ultrazohm/uz_per_sic_inverter_828xcc/commissioning/bootstrap_noload/measurement_setup.jpg

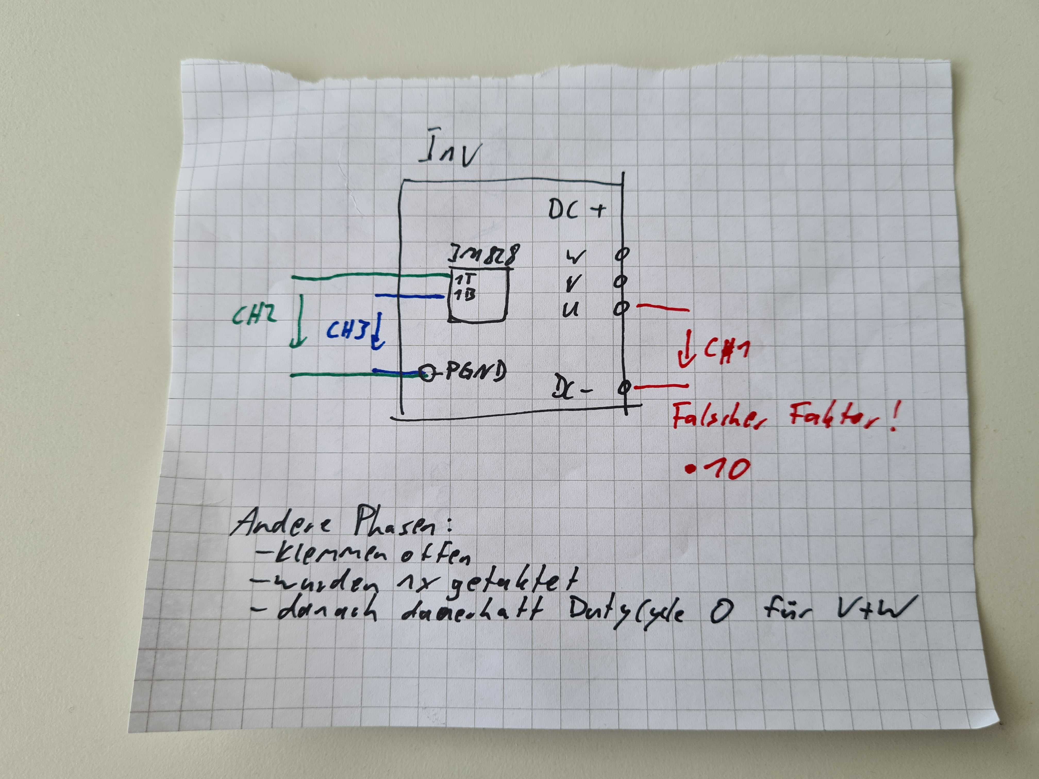
commissioning/bootstrap_noload/measurement_setup.jpg
