ultrazohm/uz_per_sic_inverter_828xcc/docs/PCB_interfaces.pptx

+24V

Ca. 100 mm

Kontur Kühlkörper, höhe 40 mm

Ca. 150 mm

Ca. 117 mm

DC+

GND

a

RJ45

IPM

b

Ca. 120 mm

RJ45

c

DC-

## Slide 2

Kühlkörper Bohrungen

Ca. 25 mm

Ca. 20 mm

IPM

Ca. 33.5 mm

Ca. 45 mm

Ca. 30 mm

Ca. 20 mm
