ultrazohm/uz_per_sic_inverter_828xcc/ghost.png

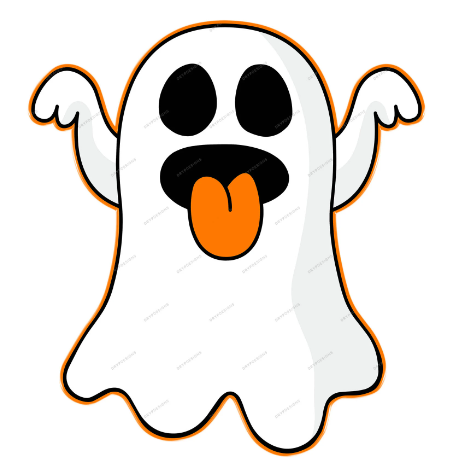
ghost.png
