ultrazohm/uz_per_sic_inverter_828xcc/docs/AssemblyForRev01JLCmissingParts.xlsx

BOT
Quantity | Comment | Designator | Value | Footprint | Supplier 1 | Supplier Part Number 1 | Supplier 2 | Supplier Part Number 2
1 | LQH43PN4R7M26L | L1 | 4.7 uH | IND | Mouser | 81-LQH43PN4R7M26L
2 | 22 µF | C6, C7 | 22 µF | C_1206 | Mouser | 810-C3216X5R1V226M
7 | 4.7 µF | C67A, C67B, C67C, C67D, C67E, C67F, C67G | 4.7 µF | C_0805 | Mouser | 810-C2012X7R475K125C
1 | LTC6992HS6-4#WTRMPBF | IC6 |  | SOT95P280X100-6N | Mouser | 584-6992HS64WTRMPBF
1 | IM828XCCXKMA1 | IC5 | 900V 20A | IM828XCCXKMA1 | Mouser | 726-IM828XCCXKMA1
TOP
1 | NXJ2S2415MC-R7 | IC3 | 2 W | DCDC | Mouser | 580-NXJ2S2415MC-R7
1 | NXJ2S0505MC-R7 | IC4 | 2 W | DCDC | Digi-Key | 811-3818-1-ND
5 | 22 µF | C17, C18, C37, C40, C42 | 22 µF | C_1206 | Mouser | 810-C3216X5R1V226M
2 | LQM31PN4R7M00L | L2, L3 | 375 mOhm | IND 1206_3216 | Mouser | 81-LQM31PN4R7M00L
1 | LM4040 5.0V | D1 | LM4040 5.0V | SOT-23-3 | Mouser | 700-LM4040CIM3-5.0T
3 | 4.7 µF | C13, C16, C23 | 4.7 µF | C_0805 | Mouser | 810-C2012X7R475K125C
4 | TC7SZ86FU,LJ(CT | IC13A, IC13B, IC13C, IC13D | 5.5 V | SOT353-1_N | Mouser | 757-TC7SZ86FULJCT | Digi-Key | TC7SZ86FULJ(CTCT-ND
4 | LM2903M8-13 | IC12A, IC12B, IC12C, IC12D |  | MSOP-8 (RM-8) | Mouser | 621-LM2903M8-13
1 | VO617A-2X017T | OP1 |  | SMD4 | Mouser | 78-VO617A-2X017T
1 | SN74HCS32PWR | IC1 | 6 V | TSSOP-14 | Mouser | 595-SN74HCS32PWR
10 | 40 µF | C24, C25, C26, C27, C28, C29, C30, C31, C32, C33 | 40 µF | B32778Z | Mouser | 871-B32778Z0406K000
2 | 100 nF | C34, C35 | 100 nF | WIMA | Mouser | 505-M10.1/1600/10P
1 | RJHSE538002 | J10 |  | RJHSE-5380-02 | Farnell | 1860605
7 | HFBR-2521Z | J1A, J1B, J1C, J1D, J1E, J1F, J1G |  | HFBRx5XX | Mouser | 630-HFBR-2521Z | Digi-Key
2 | HFBR-1521Z | J2A, J2B |  | HFBRx5XX | Mouser | 630-HFBR-1521Z | Digi-Key | 516-2043-ND
3 | FCR7350B, PCB mount 4mm jack, BLACK | J3, J6, J9 | PCB mount 4mm jack, Black FCR7350B, 1000V, 24A | FCR7350 | Digi-Key | 3185-FCR7350B-ND | farnell | 1854507
2 | FCR7350R, PCB mount 4mm jack, RED | J4, J5 | PCB mount 4mm jack, Red FCR7350R, 1000V, 24A | FCR7350 | Digi-Key | 3185-FCR7350R-ND | farnell | 1854508
2 | FCR7350L, PCB mount 4mm jack, BLUE | J7, J8 | PCB mount 4mm jack, Blue FCR7350L, 1000V, 24A | FCR7350 | Digi-Key | 3185-FCR7350L-ND | farnell | 1854511
4 | CAS5015SRA-LI | IC8A, IC8B, IC8C, IC8D |  |  | Sensitec | CAS5015SRA-LI
SUM | 68
