ultrazohm/uz_per_sic_inverter_828xcc/Project Outputs for UZ_PER_SiC_inverter_828xcc/BOM/BOM_UZ_PER_SiC_inverter_828xcc_Rev01 - Kopie.xlsx

Quantity | Comment | Designator | MF | MPN | Value | Description | Footprint | Package | Voltage | Dielectric | Supplier 1 | Supplier Part Number 1 | Supplier 2 | Supplier Part Number 2 | Supplier 3 | Supplier Part Number 3 | Anzahl Boards |  |  | Vorhanden | Bestellt bei
44 | 0.1 µF | C1, C2, C5, C8, C9, C14, C15, C21, C22, C38, C39, C41, C43, C44, C57A, C57B, C57C, C57D, C61A, C61B, C61C, C61D, C64A, C64B, C64C, C64D, C66A, C66B, C66C, C66D, C66E, C66F, C66G, C68A, C68B, C71A, C71B, C71C, C71D, C72A, C72B, C72C, C72D, C73 |  |  | 0.1 µF | Capacitor 0603, 50 VDC, 0.1 µF, X7R | C_0603 |  |  |  | Mouser | 80-C0603X104K5R7411 | LCSC | C14663 |  |  | 7 | 308
9 | 10 µF | C3, C4, C10, C11, C12, C19, C20, C69, C70 |  |  | 10 µF | Capacitor 1206, 50 VDC, 10 µF, X7R | C_1206 |  |  |  | Mouser | 810-CGA5L1X7R1H106K1 |  |  |  |  | 7 | 63
7 | 22 µF | C6, C7, C17, C18, C37, C40, C42 |  |  | 22 µF | Capacitor 1206, 35 VDC, 22µF, X5R | C_1206 |  |  |  | Mouser | 810-C3216X5R1V226M |  |  |  |  | 7 | 49 | x | 60 | Mouser
10 | 4.7 µF | C13, C16, C23, C67A, C67B, C67C, C67D, C67E, C67F, C67G |  |  | 4.7 µF | Capacitor 0805, 50 VDC, 4.7 µF, X7R | C_0805 |  |  |  | Mouser | 810-C2012X7R475K125C |  |  |  |  | 7 | 70 | x | 100 | Mouser
10 | 40 µF | C24, C25, C26, C27, C28, C29, C30, C31, C32, C33 |  |  | 40 µF | Film Capacitors, 40 µF, 1000 VDC for DC Link | B32778Z |  |  |  | Mouser | 871-B32778Z0406K000 |  |  |  |  | 7 | 70 | x | 50 | Mouser 20
2 | 100 nF | C34, C35 |  |  | 100 nF | Folienkondensatoren 1600V .10uF 10% PCM 27.5 | WIMA |  |  |  | Mouser | 505-M10.1/1600/10P |  |  |  |  | 7 | 14 | x | 20 | Mouser
15 | 1 nF | C36, C45, C46, C47, C48, C49, C50, C56A, C56B, C56C, C56D, C65A, C65B, C65C, C65D |  |  | 1 nF | Capacitor 0603, 50 VDC, 1 nF, C0G, Capacitor 0603, 50 VDC, 1 nF, NP0 | C_0603 |  |  |  | Mouser, LCSC | 581-06035A102J, C106246 |  |  |  |  | 7 | 105
8 | 330 pF | C51A, C51B, C51C, C51D, C55A, C55B, C55C, C55D |  |  | 330 pF | Capacitor 0603, 50 VDC, 330 pF, X7R | C_0603 |  |  |  | Mouser | 80-C0603X331J5R3112 |  |  |  |  | 7 | 56
16 | 22 pF | C52A, C52B, C52C, C52D, C54A, C54B, C54C, C54D, C58A, C58B, C58C, C58D, C63A, C63B, C63C, C63D |  |  | 22 pF | Capacitor 0603, 50 VDC, 22 pF, X7R | C_0603 |  |  |  | Mouser | 80-C0603C220J5R |  |  |  |  | 7 | 112
12 | 1 µF | C53A, C53B, C53C, C53D, C59A, C59B, C59C, C59D, C62A, C62B, C62C, C62D |  |  | 1 µF | 50V 1uF X7R ±10% 0603 Multilayer Ceramic Capacitors MLCC - SMD/SMT ROHS | C_0603 |  |  |  | LCSC | C105174 | Mouser | 963-UMK107AB7105MA-T |  |  | 7 | 84
4 | 2.2 nF | C60A, C60B, C60C, C60D |  |  | 2.2 nF | Capacitor 0603, 50 VDC, 2.2 nF, X7R | C_0603 |  |  |  | Mouser | 581-06035C222J |  |  |  |  | 7 | 28
1 | LM4040 5.0V | D1 |  |  | LM4040 5.0V | Voltage Reference, 5.0V, ±0.5%, ±15mA | SOT-23-3 |  |  |  | Mouser | 700-LM4040CIM3-5.0T |  |  |  |  | 7 | 7 | x | 10 | Mouser
7 | 150060RS86000 | D2A, D2B, D2C, D2D, D2E, D2F, D2G |  |  |  | WL-SMCW SMD Mono-color Chip LED Waterclear Red | WL-SMCW_0603 |  |  |  | Mouser | 710-150060RS86000 | Farnell | 3408608 | Digi-Key | 732-150060RS86000CT-ND | 7 | 49
6 | 150060GS84000 | D3A, D3B, D4, D5, D6, D7 |  |  |  | WL-SMCW SMD Mono-color Chip LED Waterclear Green | WL-SMCW_0603 |  |  |  | Mouser | 710-150060GS84000 | Farnell | 3408612 | Digi-Key | 732-150060GS84000CT-ND | 7 | 42
1 | 0154.500DR | F1 |  |  | 500 mA | Fuse OMNI BLOK 154 | Littlefuse_154 |  |  |  | Mouser | 576-0154.500DR |  |  |  |  | 7 | 7
1 | SN74HCS32PWR | IC1 |  |  | 6 V | Logische Gatter Quadruple 2-input OR gates with Schmitt-trigger inputs 14-TSSOP -40 to 125 | TSSOP-14 |  |  |  | Mouser | 595-SN74HCS32PWR |  |  |  |  | 7 | 7 | x | 10 | Mouser
1 | AP63205WU-7 | IC2 |  |  |  | Switching Voltage Regulators DCDC Conv HV Buck TSOT26 T&R 3K | TSOT26-6 |  |  |  | Mouser | 621-AP63205WU-7 |  |  |  |  | 7 | 7 |  | 10
1 | NXJ2S2415MC-R7 | IC3 |  |  | 2 W | Isolated DC/DC Converters - SMD 21.6V TO 26.4V IN 15V OUT | DCDC |  |  |  | Mouser | 580-NXJ2S2415MC-R7 |  |  |  |  | 7 | 7 | x | 5 | Farnell 3
1 | NXJ2S0505MC-R7 | IC4 |  |  | 2 W | Isolated DC/DC Converters - SMD 4.5V TO 5.5V IN 5V OUT | DCDC |  |  |  | Digi-Key | 811-3818-1-ND |  |  |  |  | 7 | 7 | x | 6 | Digikey 3
1 | IM828XCCXKMA1 | IC5 |  |  | 900V 20A | Motor/Motion/Ignition Controllers & Drivers SiC MOSFET | IM828XCCXKMA1 |  |  |  | Mouser | 726-IM828XCCXKMA1 |  |  |  |  | 7 | 7 | x | 5 | Mouser 3
1 | LTC6992HS6-4#WTRMPBF | IC6 |  |  |  | Switching Controllers PWM with 5% to 100% Pulse Width Control | SOT95P280X100-6N |  |  |  | Mouser | 584-6992HS64WTRMPBF |  |  |  |  | 7 | 7 |  | 10
8 | ADA4940-1ARZ-R7 | IC7A, IC7B, IC7C, IC7D, IC9A, IC9B, IC9C, IC9D |  |  | differential ADC driver | Differential ADC Driver | SOIC-8-N |  |  |  | Mouser | 584-ADA4940-1ARZ-R7 |  |  |  |  | 7 | 56 |  | 50
4 | CAS5015SRA-LI | IC8A, IC8B, IC8C, IC8D |  |  | 15A | 15A, 1.1%, 400kHz | CAS50xxSRA |  |  |  | RS | 216-9746 |  |  |  |  | 7 | 28 | x | 20 | n. bestellt
9 | SN74LVC1G14DBV | IC10A, IC10B, IC10C, IC10D, IC10E, IC10F, IC10G, IC11A, IC11B |  |  | 5.5 V | Inverting Schmitt trigger | SOT23-5_L |  |  |  | Mouser | 595-SN74LVC1G14DBVT |  |  |  |  | 7 | 63 |  | 70
4 | LM2903M8-13 | IC12A, IC12B, IC12C, IC12D |  |  |  | Analoge Komparatoren Comparator | MSOP-8 (RM-8) |  |  |  | Mouser | 621-LM2903M8-13 |  |  |  |  | 7 | 28 | x | 35 | Digikey
4 | TC7SZ86FU,LJ(CT | IC13A, IC13B, IC13C, IC13D |  |  | 5.5 V | IC GATE XOR 1CH 2-INP USV | SOT353-1_N |  |  |  | Mouser | 757-TC7SZ86FULJCT | Digi-Key | TC7SZ86FULJ(CTCT-ND |  |  | 7 | 28 | x | 10 | Digikey 30
7 | HFBR-2521Z | J1A, J1B, J1C, J1D, J1E, J1F, J1G | Boadcom/Avago | HFBR-2521Z |  | Fibre Optic Receivers, LINK HORIZ 5MBd RC VR RoHS | HFBRx5XX |  |  |  | Mouser | 630-HFBR-2521Z | Digi-Key |  |  |  | 7 | 49 | x | 35
2 | HFBR-1521Z | J2A, J2B | Broadcom/Avago | HFBR-1521Z |  | Fibre Optic Transmitters, Link Horiz 5MBd Tx RoHS | HFBRx5XX |  |  |  | Mouser | 630-HFBR-1521Z | Digi-Key | 516-2043-ND |  |  | 7 | 14 | x | 10
3 | FCR7350B, PCB mount 4mm jack, BLACK | J3, J6, J9 |  |  | PCB mount 4mm jack, Black FCR7350B, 1000V, 24A | FCR7350B, 1000V, 24A, BLACK | FCR7350 |  |  |  | Digi-Key | 3185-FCR7350B-ND | farnell | 1854507 |  |  | 7 | 21 | x | 15 | Farnell 6
2 | FCR7350R, PCB mount 4mm jack, RED | J4, J5 |  |  | PCB mount 4mm jack, Red FCR7350R, 1000V, 24A | FCR7350B, 1000V, 24A, RED | FCR7350 |  |  |  | Digi-Key | 3185-FCR7350R-ND | farnell | 1854508 |  |  | 7 | 14 | x | 10 | Farnell 4
2 | FCR7350L, PCB mount 4mm jack, BLUE | J7, J8 |  |  | PCB mount 4mm jack, Blue FCR7350L, 1000V, 24A | FCR7350B, 1000V, 24A, BLUE | FCR7350 |  |  |  | Digi-Key | 3185-FCR7350L-ND | farnell | 1854511 |  |  | 7 | 14 | x | 1 | Farnell 13
1 | RJHSE538002 | J10 |  |  |  | CAT5, RJ45 Connector, 1x2 | RJHSE-5380-02 |  |  |  | Farnell | 1860605 |  |  |  |  | 7 | 7 | x | 10 | Farnell
1 | LQH43PN4R7M26L | L1 | EPCOS / TDK | B82464G4154M | 4.7 uH | Leistungsinduktivitäten – SMD 4.7 UH 20% | IND |  |  |  | Mouser | 81-LQH43PN4R7M26L |  |  |  |  | 7 | 7 | x | 20 | Mouser
2 | LQM31PN4R7M00L | L2, L3 | EPCOS / TDK | B82464G4154M | 375 mOhm | Power Inductors - SMD 4.7 UH 20% | IND 1206_3216 |  |  |  | Mouser | 81-LQM31PN4R7M00L |  |  |  |  | 7 | 14 |  | 25
1 | VO617A-2X017T | OP1 |  |  |  | Transistor-Ausgangsoptokoppler H. Relblty 5300 Vrms 63-125% CTR, VDE | SMD4 |  |  |  | Mouser | 78-VO617A-2X017T |  |  |  |  | 7 | 7 | x | 10 | Farnell
1 | T2N7002AK,LM | Q1 |  |  | 60 V | Small-signal MOSFET, n-Channel, 200 mA, 60 V | SOT-23-3 |  |  |  | Mouser | 757-T2N7002AKLM | Digi-Key | T2N7002AKLMCT-ND |  |  | 7 | 7 |  | 10
2 | 270R | R1, R2 |  |  | 270R | SMD resistor E24 series | RES 0603_1608 |  |  |  | Mouser | 660-RK73B1JTTDD271J |  |  |  |  | 7 | 14
6 | 10k | R3, R51A, R51B, R52A, R52B, R61 |  |  | 10k | SMD resistor 1%, SMD resistor E24 series | RES 0603_1608 |  |  |  | Farnell, Mouser | 2447230, 660-RK73B1JTTD103J |  |  |  |  | 7 | 42
3 | 18k | R4, R56, R58 |  |  | 18k | SMD resistor E24 series | RES 0603_1608 |  |  |  | Mouser | 660-RK73B1JTTD183J |  |  |  |  | 7 | 21
39 | 100R | R5, R11, R12, R13, R14, R15, R16, R25A, R25B, R25C, R25D, R27A, R27B, R27C, R27D, R28A, R28B, R28C, R28D, R30A, R30B, R30C, R30D, R40A, R40B, R40C, R40D, R42A, R42B, R42C, R42D, R43A, R43B, R43C, R43D, R45A, R45B, R45C, R45D |  |  | 100R | SMD resistor E24 series | RES 0603_1608 |  |  |  | Mouser | 660-RK73B1JTTD101J | LCSC | C22775 |  |  | 7 | 273
1 | 12k | R6 |  |  | 12k | SMD resistor E24 series 12 kOhms 100mW 0603 1% | RES 0603_1608 |  |  |  | Mouser | 603-AC0603FR-1012KL |  |  |  |  | 7 | 7
1 | 470k | R7 |  |  | 470k | SMD resistor E24 series 470 kOhms 100-200 mW 0603 1% | RES 0603_1608 |  |  |  | Mouser | 603-RC0603FR-10470KL |  |  |  |  | 7 | 7
1 | 287k | R8 |  |  | 287k | SMD resistor 1% | RES 0805_2012 |  |  |  | Mouser | 667-ERJ-6ENF2873V |  |  |  |  | 7 | 7
1 | 976k | R9 |  |  | 976k | SMD resistor 1%, 50V, 100ppm | RES 0603_1608 |  |  |  | Mouser | 652-CR0603FX-9763ELF |  |  |  |  | 7 | 7
1 | 182k | R10 |  |  | 182k | SMD resistor 1%, 50V, 100ppm | RES 0603_1608 |  |  |  | Mouser | 652-CR0603FX-1823ELF |  |  |  |  | 7 | 7
48 | 330K | R17A, R17B, R17C, R17D, R18A, R18B, R18C, R18D, R19A, R19B, R19C, R19D, R20A, R20B, R20C, R20D, R21A, R21B, R21C, R21D, R22A, R22B, R22C, R22D, R33A, R33B, R33C, R33D, R34A, R34B, R34C, R34D, R35A, R35B, R35C, R35D, R36A, R36B, R36C, R36D, R37A, R37B, R37C, R37D, R38A, R38B, R38C, R38D |  |  | 330K | SMD resistor E24 series 330K OHM 1% 50PPM 1/4W | RES 1206_3216 |  |  |  | Mouser | 603-RT1206FRE07330KL |  |  |  |  | 7 | 336
16 | 220k | R23A, R23B, R23C, R23D, R24A, R24B, R24C, R24D, R31A, R31B, R31C, R31D, R32A, R32B, R32C, R32D |  |  | 220k | SMD resistor 1% | RES 0603_1608 |  |  |  | Mouser | 603-AC0603FR-07220KL |  |  |  |  | 7 | 112
8 | 22K | R26A, R26B, R26C, R26D, R29A, R29B, R29C, R29D |  |  | 22K | SMD resistor E24 series 22K 0.5% 1/10W 75 Volts 50ppm | RES 0603_1608 |  |  |  | Mouser | 603-RT0603DRE0722KL |  |  |  |  | 7 | 56
8 | 2k | R39A, R39B, R39C, R39D, R46A, R46B, R46C, R46D |  |  | 2k | SMD resistor 0.1% | RES 0603_1608 |  |  |  | Mouser | 667-ERA-3VEB2001V |  |  |  |  | 7 | 56
8 | 1k | R41A, R41B, R41C, R41D, R44A, R44B, R44C, R44D |  |  | 1k | SMD resistor 0.1% | RES 0603_1608 |  |  |  | Mouser | 66-PCFW0603LF031001B |  |  |  |  | 7 | 56
7 | 43k | R47A, R47B, R47C, R47D, R47E, R47F, R47G |  |  | 43k | SMD resistor E24 series | RES 0603_1608 |  |  |  | Mouser | 660-RK73B1JTTD433J |  |  |  |  | 7 | 49
12 | 3k9 | R48A, R48B, R48C, R48D, R48E, R48F, R48G, R49A, R49B, R57, R59, R60 |  |  | 3k9 | SMD resistor E24 series | RES 0603_1608 |  |  |  | Mouser | 660-RK73B1JTTDD392J |  |  |  |  | 7 | 84
2 | 150R | R50A, R50B |  |  | 150R | SMD resistor E24 series | RES 0603_1608 |  |  |  | Mouser | 660-RK73B1JTTD151J |  |  |  |  | 7 | 14
8 | 5.6k | R53A, R53B, R53C, R53D, R55A, R55B, R55C, R55D |  |  | 5.6k | SMD resistor E24 series 5.6 kOhms 100mW 0603 1% | RES 0603_1608 |  |  |  | Mouser | 603-AC0603FR-075K6L |  |  |  |  | 7 | 56
4 | 33k | R54A, R54B, R54C, R54D |  |  | 33k | SMD resistor E24 series | RES 0603_1608 |  |  |  | Mouser | 603-AC0603FR-1333KL |  |  |  |  | 7 | 28
