ultrazohm/uz_per_sic_inverter_828xcc/docs/IM828_kritIC_Liste.xlsx

Herstellernr |  | Menge pro pcb | Für 5PCB
NXJ2S2415MC | NXJ2S2415MC-R7 | 1 | 5
AP63205 | AP63205WU-7 | 1 | 5
IM828XCC | IM828XCCXKMA1 | 1 | 5
SN74LVC1G14 | SN74LVC1G14DBVT | 11 | 55
ADA4940 | ADA4940-1ARZ | 8 | 40
CAS5000 | CAS5025SRA-LI | 4 | 20
LTC6992 | LTC6992HS6-4#WTRMPBF | 1 | 5
NXJ2S0505MC |  | 1 | 5
 |  |  | 0
LQM31PN4R7M00L |  | 3 | 15
B32778Z |  | 10 | 50
2220Y6300105KXTWS2 |  | 6 | 30
LTV-356T |  | 1 | 5
LM358DR |  | 1 | 5
TC7SZ86FU,LJ(CT |  | 1 | 5
T2N7002AK,LM |  | 1 | 5
4mm Buchse bk |  | 3 | 15 | 17 bestellt wegen phase fault pcb
4mm Buchse rd |  | 2 | 10
4mm Buchse bl |  | 2 | 10
