ultrazohm/uz_per_sic_inverter_828xcc/(list of files, cad)

Other CAD files:
cad/IC8C.SLDASM
cad/R71D.SLDASM
cad/R91A-subassembly-1.SLDASM
cad/IC6A.SLDASM
cad/R19-subassembly-1.SLDASM
cad/J2B.SLDASM
cad/R2.SLDASM
cad/R33B-subassembly-1.SLDASM
cad/R82A-subassembly-1.SLDASM
cad/R91D-subassembly-1.SLDASM
cad/R80B-subassembly-1.SLDASM
cad/R72A.SLDASM
cad/R80B.SLDASM
cad/C13.SLDASM
cad/C35.SLDASM
cad/R86B.SLDASM
cad/C71F.SLDASM
cad/R40D-subassembly-1.SLDASM
cad/C71C.SLDASM
cad/R80D.SLDASM
cad/R74B.SLDASM
cad/R93B.SLDASM
cad/C66D.SLDASM
cad/R92A-subassembly-1.SLDASM
cad/C54C.SLDASM
cad/R89D.SLDASM
cad/R31-subassembly-1.SLDASM
cad/R84D-subassembly-1.SLDASM
cad/C64C.SLDASM
cad/C37.SLDASM
cad/R37B.SLDASM
cad/R71C.SLDASM
cad/C28-subassembly-1.SLDASM
cad/C66A.SLDASM
cad/R34D-subassembly-1.SLDASM
cad/R48A-subassembly-1.SLDASM
cad/R54B.SLDASM
cad/R41B.SLDASM
cad/R24.SLDASM
cad/R43D-subassembly-1.SLDASM
cad/C22.SLDASM
cad/R61B.SLDASM
cad/R70C.SLDASM
cad/C27.SLDASM
cad/L2.SLDASM
cad/C26-subassembly-1.SLDASM
cad/R87D.SLDASM
cad/R27.SLDASM
cad/R48D.SLDASM
cad/R33D.SLDASM
cad/R87C-subassembly-1.SLDASM
cad/R42B.SLDASM
cad/R82C-subassembly-1.SLDASM
cad/R3-subassembly-1.SLDASM
cad/R32C.SLDASM
cad/R69D-subassembly-1.SLDASM
cad/C72-subassembly-1.SLDASM
cad/R62C-subassembly-1.SLDASM
cad/C21.SLDASM
cad/Pins-2.SLDASM
cad/R57B.SLDASM
cad/R52D-subassembly-1.SLDASM
cad/R50D.SLDASM
cad/R59B.SLDASM
cad/C15.SLDASM
cad/R52A-subassembly-1.SLDASM
cad/R59D-subassembly-1.SLDASM
cad/R42A-subassembly-1.SLDASM
cad/R66B.SLDASM
cad/R55C.SLDASM
cad/C68B.SLDASM
cad/R42D.SLDASM
cad/R80A.SLDASM
cad/D1D.SLDASM
cad/R38C-subassembly-1.SLDASM
cad/C38-subassembly-1.SLDASM
cad/C56A.SLDASM
cad/C70B.SLDASM
cad/R54A-subassembly-1.SLDASM
cad/C68D.SLDASM
cad/R22-subassembly-1.SLDASM
cad/R56D.SLDASM
cad/R46B.SLDASM
cad/R67D-subassembly-1.SLDASM
cad/C4.SLDASM
cad/R86A-subassembly-1.SLDASM
cad/C66B.SLDASM
cad/R83A-subassembly-1.SLDASM
cad/R93C-subassembly-1.SLDASM
cad/R23-subassembly-1.SLDASM
cad/IC7D.SLDASM
cad/R86A.SLDASM
cad/R39A.SLDASM
cad/C70E.SLDASM
cad/J5.SLDASM
cad/R77C-subassembly-1.SLDASM
cad/R32D-subassembly-1.SLDASM
cad/R17.SLDASM
cad/R87D-subassembly-1.SLDASM
cad/R82B-subassembly-1.SLDASM
cad/R79D-subassembly-1.SLDASM
cad/R80C-subassembly-1.SLDASM
cad/R72D-subassembly-1.SLDASM
cad/R35D-subassembly-1.SLDASM
cad/R80D-subassembly-1.SLDASM
cad/R66D.SLDASM
cad/R49D-subassembly-1.SLDASM
cad/C9-subassembly-1.SLDASM
cad/R40B-subassembly-1.SLDASM
cad/R78B.SLDASM
cad/C25-subassembly-1.SLDASM
cad/C56B.SLDASM
cad/R17-subassembly-1.SLDASM
cad/R58A-subassembly-1.SLDASM
cad/R42B-subassembly-1.SLDASM
cad/J1A.SLDASM
cad/C57A.SLDASM
cad/R68C.SLDASM
cad/C56C.SLDASM
cad/R33C.SLDASM
cad/R89A-subassembly-1.SLDASM
cad/C20.SLDASM
cad/R20.SLDASM
cad/IC1.SLDASM
cad/C16.SLDASM
cad/R43A.SLDASM
cad/R55C-subassembly-1.SLDASM
cad/R41D.SLDASM
cad/R82B.SLDASM
cad/R66C.SLDASM
cad/R93C.SLDASM
cad/R80C.SLDASM
cad/R73C.SLDASM
cad/R77A-subassembly-1.SLDASM
cad/C55A.SLDASM
cad/C14.SLDASM
cad/R50B-subassembly-1.SLDASM
cad/L1-subassembly-1.SLDASM
cad/R87A.SLDASM
cad/R46D.SLDASM
cad/R69B-subassembly-1.SLDASM
cad/R55D.SLDASM
cad/R87B.SLDASM
cad/R41D-subassembly-1.SLDASM
cad/C71G.SLDASM
cad/R71A-subassembly-1.SLDASM
cad/R8-subassembly-1.SLDASM
cad/R72B.SLDASM
cad/R21.SLDASM
cad/R79C.SLDASM
cad/0603 resistor-1.SLDPRT
cad/0603 resistor.SLDPRT
cad/0805 resistor-1.SLDPRT
cad/0805 resistor.SLDPRT
cad/1206 resistor-1.SLDPRT
cad/1206 resistor.SLDPRT
cad/5145.3021.0._BG1.02_CAS5050SRA-KH.SLDPRT
cad/6126536864-1.SLDPRT
cad/6126536864-2.SLDPRT
cad/6126536864-3.SLDPRT
cad/6126536864-4.SLDPRT
cad/6126536864.SLDPRT
cad/6126538464.SLDASM
cad/6126538544-1.SLDPRT
cad/6126538544-2.SLDPRT
cad/6126538544-3.SLDPRT
cad/6126538544-4.SLDPRT
cad/6126538544.SLDPRT
cad/6126538944-subassembly-1.SLDASM
cad/6126538944.SLDASM
cad/6126539824-1.SLDPRT
cad/6126539824-2.SLDPRT
cad/6126539824-3.SLDPRT
cad/6126539824-4.SLDPRT
cad/6126539824.SLDPRT
cad/6126539904-subassembly-1.SLDASM
cad/6126539904.SLDASM
cad/6128714480-1.SLDPRT
cad/6128714480-2.SLDPRT
cad/6128714480-3.SLDPRT
cad/6128714480-4.SLDPRT
cad/6128714480.SLDPRT
cad/6302543936.SLDASM
cad/6302544096.SLDASM
cad/6302547296.SLDASM
cad/6302547456.SLDASM
cad/6302548896.SLDASM
cad/6302549056.SLDASM
cad/6307258816.SLDASM
cad/Avago HFBR-0500ETZ Series.SLDPRT
cad/Board-Part-1.SLDPRT
cad/Board.SLDASM
cad/Body-1.SLDPRT
cad/Body.SLDPRT
cad/C1.SLDASM
cad/C10.SLDASM
cad/C11.SLDASM
cad/C12.SLDASM
cad/C14-subassembly-1.SLDASM
cad/C15-subassembly-1.SLDASM
cad/C16-subassembly-1.SLDASM
cad/C17-subassembly-1.SLDASM
cad/C17.SLDASM
cad/C18.SLDASM
cad/C19.SLDASM
cad/C2-subassembly-1.SLDASM
cad/C2.SLDASM
cad/C21-subassembly-1.SLDASM
cad/C22-subassembly-1.SLDASM
cad/C23-subassembly-1.SLDASM
cad/C23.SLDASM
cad/C24-subassembly-1.SLDASM
cad/C24.SLDASM
cad/C25.SLDASM
cad/C26.SLDASM
cad/C27-subassembly-1.SLDASM
cad/C28.SLDASM
cad/C29-subassembly-1.SLDASM
cad/C29.SLDASM
cad/C3-subassembly-1.SLDASM
cad/C3.SLDASM
cad/C30-subassembly-1.SLDASM
cad/C30.SLDASM
cad/C31.SLDASM
cad/C32.SLDASM
cad/C33.SLDASM
cad/C34.SLDASM
cad/C36.SLDASM
cad/C38.SLDASM
cad/C39.SLDASM
cad/C40.SLDASM
cad/C41.SLDASM
cad/C42-subassembly-1.SLDASM
cad/C42.SLDASM
cad/C43.SLDASM
cad/C44-subassembly-1.SLDASM
cad/C44.SLDASM
cad/C45.SLDASM
cad/C46.SLDASM
cad/C47.SLDASM
cad/C48.SLDASM
cad/C49.SLDASM
cad/C5-subassembly-1.SLDASM
cad/C5.SLDASM
cad/C50.SLDASM
cad/C51.SLDASM
cad/C52.SLDASM
cad/C53A.SLDASM
cad/C53B.SLDASM
cad/C53C.SLDASM
cad/C53D.SLDASM
cad/C54A.SLDASM
cad/C54B.SLDASM
cad/C54D.SLDASM
cad/C55B.SLDASM
cad/C55C.SLDASM
cad/C55D.SLDASM
cad/C56D.SLDASM
cad/C57B.SLDASM
cad/C57C.SLDASM
cad/C57D.SLDASM
cad/C58A.SLDASM
cad/C58B.SLDASM
cad/C58C.SLDASM
cad/C58D.SLDASM
cad/C59A.SLDASM
cad/C59B.SLDASM
cad/C59C.SLDASM
cad/C59D.SLDASM
cad/C6-subassembly-1.SLDASM
cad/C6.SLDASM
cad/C60A.SLDASM
cad/C60B.SLDASM
cad/C60C.SLDASM
cad/C60D.SLDASM
cad/C61A.SLDASM
cad/C61B.SLDASM
cad/C61C.SLDASM
cad/C61D.SLDASM
cad/C62A.SLDASM
cad/C62B.SLDASM
cad/C62C.SLDASM
cad/C62D.SLDASM
cad/C63A.SLDASM
cad/C63B.SLDASM
cad/C63C.SLDASM
cad/C63D.SLDASM
cad/C64A.SLDASM
cad/C64B.SLDASM
cad/C64D.SLDASM
cad/C65A.SLDASM
cad/C65B.SLDASM
cad/C65C.SLDASM
cad/C65D.SLDASM
cad/C66C.SLDASM
cad/C67A.SLDASM
cad/C67B.SLDASM
cad/C67C.SLDASM
cad/C67D.SLDASM
cad/C68A.SLDASM
cad/C68C.SLDASM
cad/C69A.SLDASM
cad/C69B.SLDASM
cad/C69C.SLDASM
cad/C69D.SLDASM
cad/C7-subassembly-1.SLDASM
cad/C7.SLDASM
cad/C70A.SLDASM
cad/C70C.SLDASM
cad/C70D.SLDASM
cad/C70F.SLDASM
cad/C70G.SLDASM
cad/C71A.SLDASM
cad/C71B.SLDASM
cad/C71D.SLDASM
cad/C71E.SLDASM
cad/C72.SLDASM
cad/C73-subassembly-1.SLDASM
cad/C73.SLDASM
cad/C74A.SLDASM
cad/C74B.SLDASM
cad/C8-subassembly-1.SLDASM
cad/C8.SLDASM
cad/C9.SLDASM
cad/D1A.SLDASM
cad/D1B.SLDASM
cad/D1C.SLDASM
cad/D1E.SLDASM
cad/D1F.SLDASM
cad/D1G.SLDASM
cad/D2A.SLDASM
cad/D2B.SLDASM
cad/Exposed Cu.SLDPRT
cad/Extruded-1.SLDPRT
cad/Extruded-2.SLDPRT
cad/Extruded-3.SLDPRT
cad/Extruded-4.SLDPRT
cad/Extruded-5.SLDPRT
cad/Extruded-6.SLDPRT
cad/Extruded.SLDPRT
cad/FCR7350B.SLDASM
cad/FCR7350L.SLDASM
cad/FCR7350R.SLDASM
cad/Face-1.SLDPRT
cad/Face-2.SLDPRT
cad/Face.SLDPRT
cad/Face001-1.SLDPRT
cad/Face001-2.SLDPRT
cad/Face001.SLDPRT
cad/Face002-1.SLDPRT
cad/Face002-2.SLDPRT
cad/Face002.SLDPRT
cad/Face003-1.SLDPRT
cad/Face003-2.SLDPRT
cad/Face003.SLDPRT
cad/Face004-1.SLDPRT
cad/Face004-2.SLDPRT
cad/Face004.SLDPRT
cad/Face005-1.SLDPRT
cad/Face005-2.SLDPRT
cad/Face005.SLDPRT
cad/Face006-1.SLDPRT
cad/Face006-2.SLDPRT
cad/Face006.SLDPRT
cad/Face007-1.SLDPRT
cad/Face007-2.SLDPRT
cad/Face007.SLDPRT
cad/Face008-1.SLDPRT
cad/Face008-2.SLDPRT
cad/Face008.SLDPRT
cad/Face009-1.SLDPRT
cad/Face009-2.SLDPRT
cad/Face009.SLDPRT
cad/Face010-1.SLDPRT
cad/Face010-2.SLDPRT
cad/Face010.SLDPRT
cad/Face011-1.SLDPRT
cad/Face011-2.SLDPRT
cad/Face011.SLDPRT
cad/Face012-1.SLDPRT
cad/Face012-2.SLDPRT
cad/Face012.SLDPRT
cad/Face013-1.SLDPRT
cad/Face013-2.SLDPRT
cad/Face013.SLDPRT
cad/Face014-1.SLDPRT
cad/Face014-2.SLDPRT
cad/Face014.SLDPRT
cad/Face015-1.SLDPRT
cad/Face015-2.SLDPRT
cad/Face015.SLDPRT
cad/Face016-1.SLDPRT
cad/Face016-2.SLDPRT
cad/Face016.SLDPRT
cad/Face017-1.SLDPRT
cad/Face017-2.SLDPRT
cad/Face017.SLDPRT
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
