ultrazohm/uz_per_sic_inverter_828xcc/commissioning/bootstrap_noload/udc050v.png

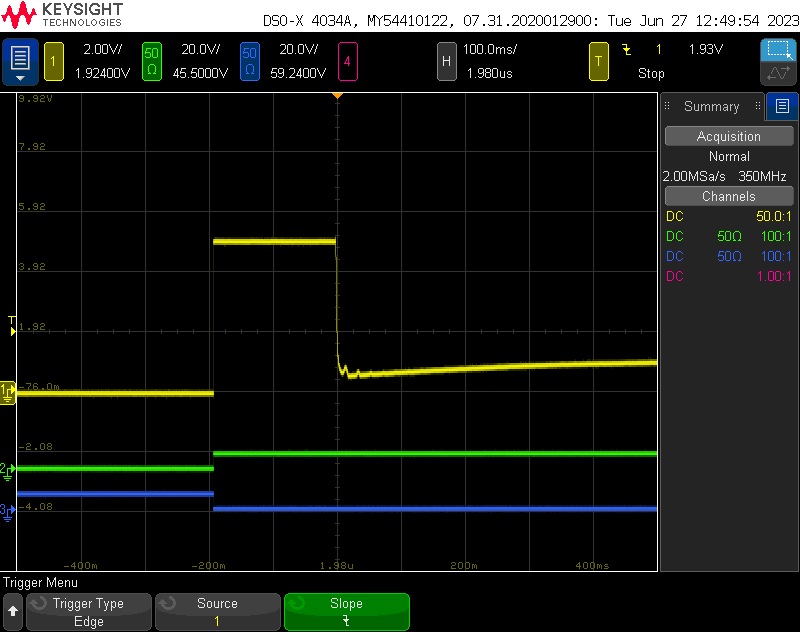
commissioning/bootstrap_noload/udc050v.png
