ultrazohm/uz_per_sic_inverter_828xcc/DCDCFix/Test_Procedure_DC_fix.docx

Test Procedure DC-Fix 24/15V

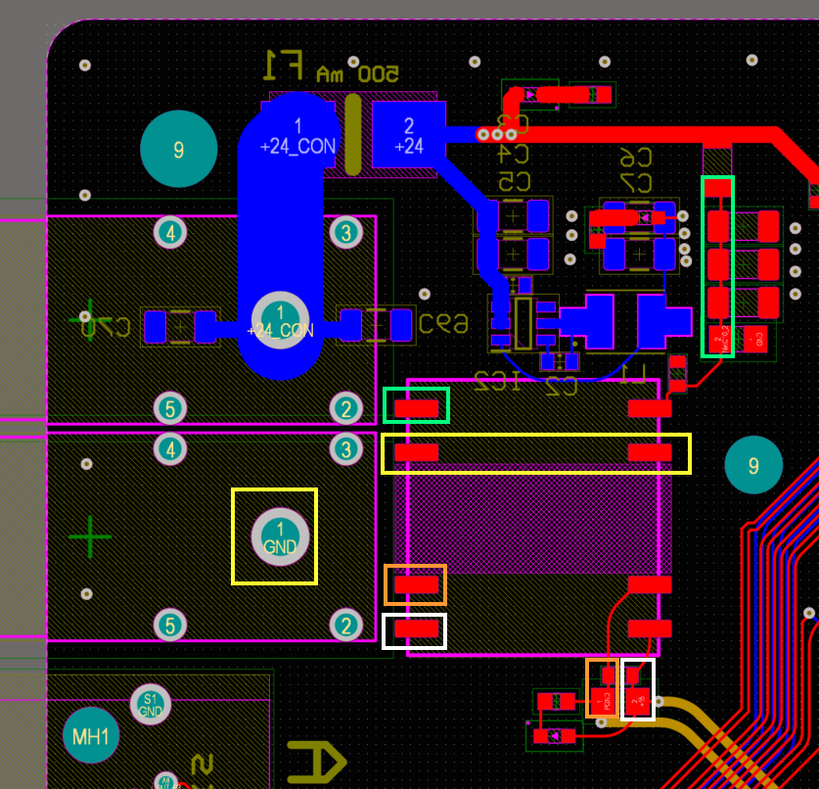
[picture p4: figure]

Test connection between nets of same color

Test Procedure DC-Fix 05/05 V

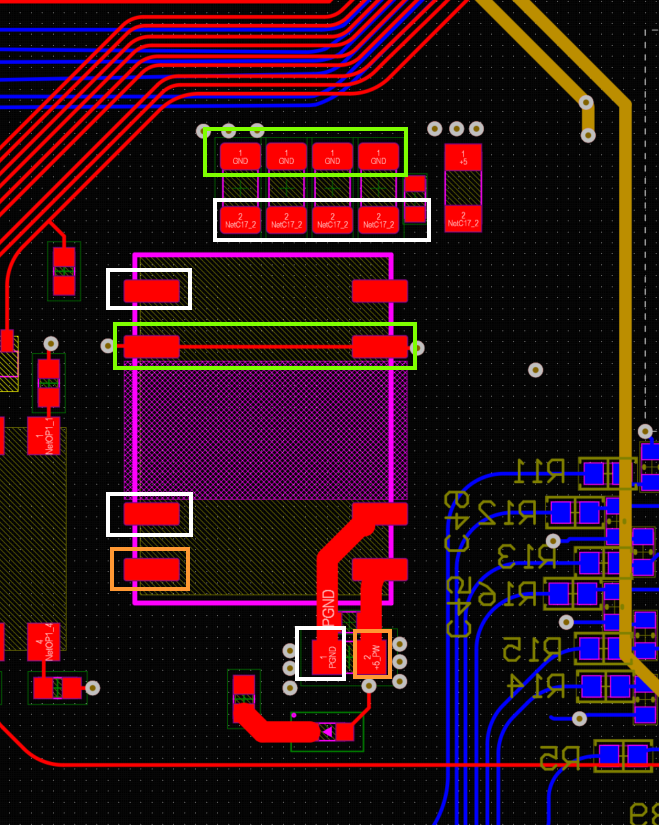
[picture p5: figure]

Test connection between nets of same color
