ultrazohm/uz_per_sic_inverter_828xcc/Project Outputs for UZ_PER_SiC_inverter_828xcc/Rev01/SCH_UZ_PER_SiC_inverter_828xcc_[No Variations]_Rev01.PDF

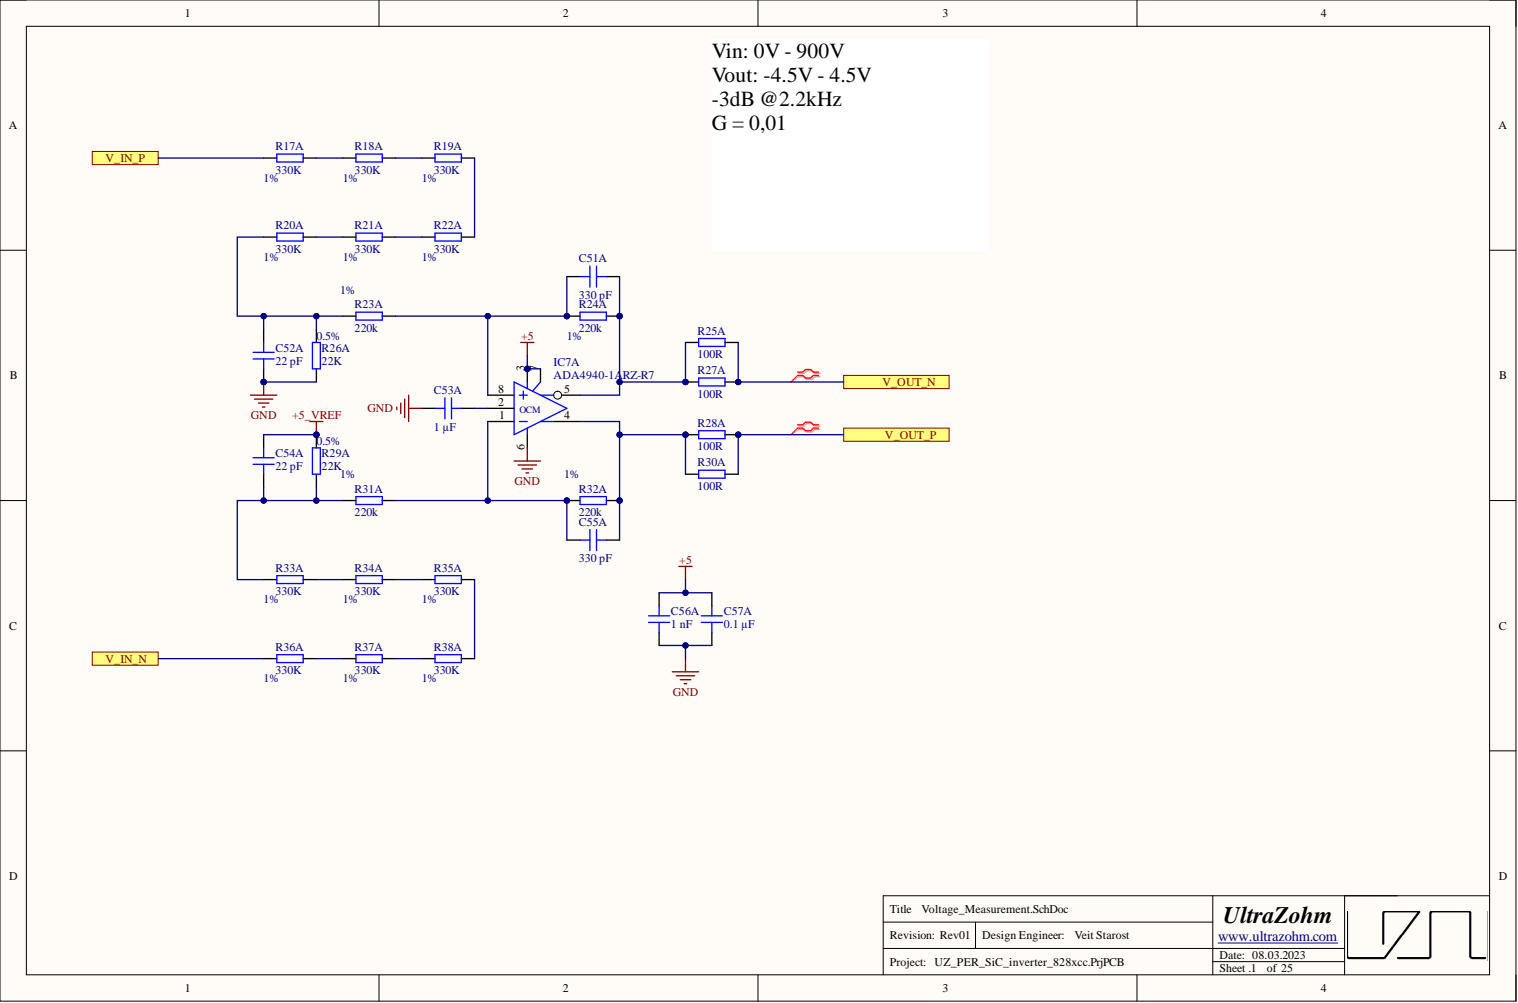
[picture p6: page 1]

Revision:

Date: 08.03.2023

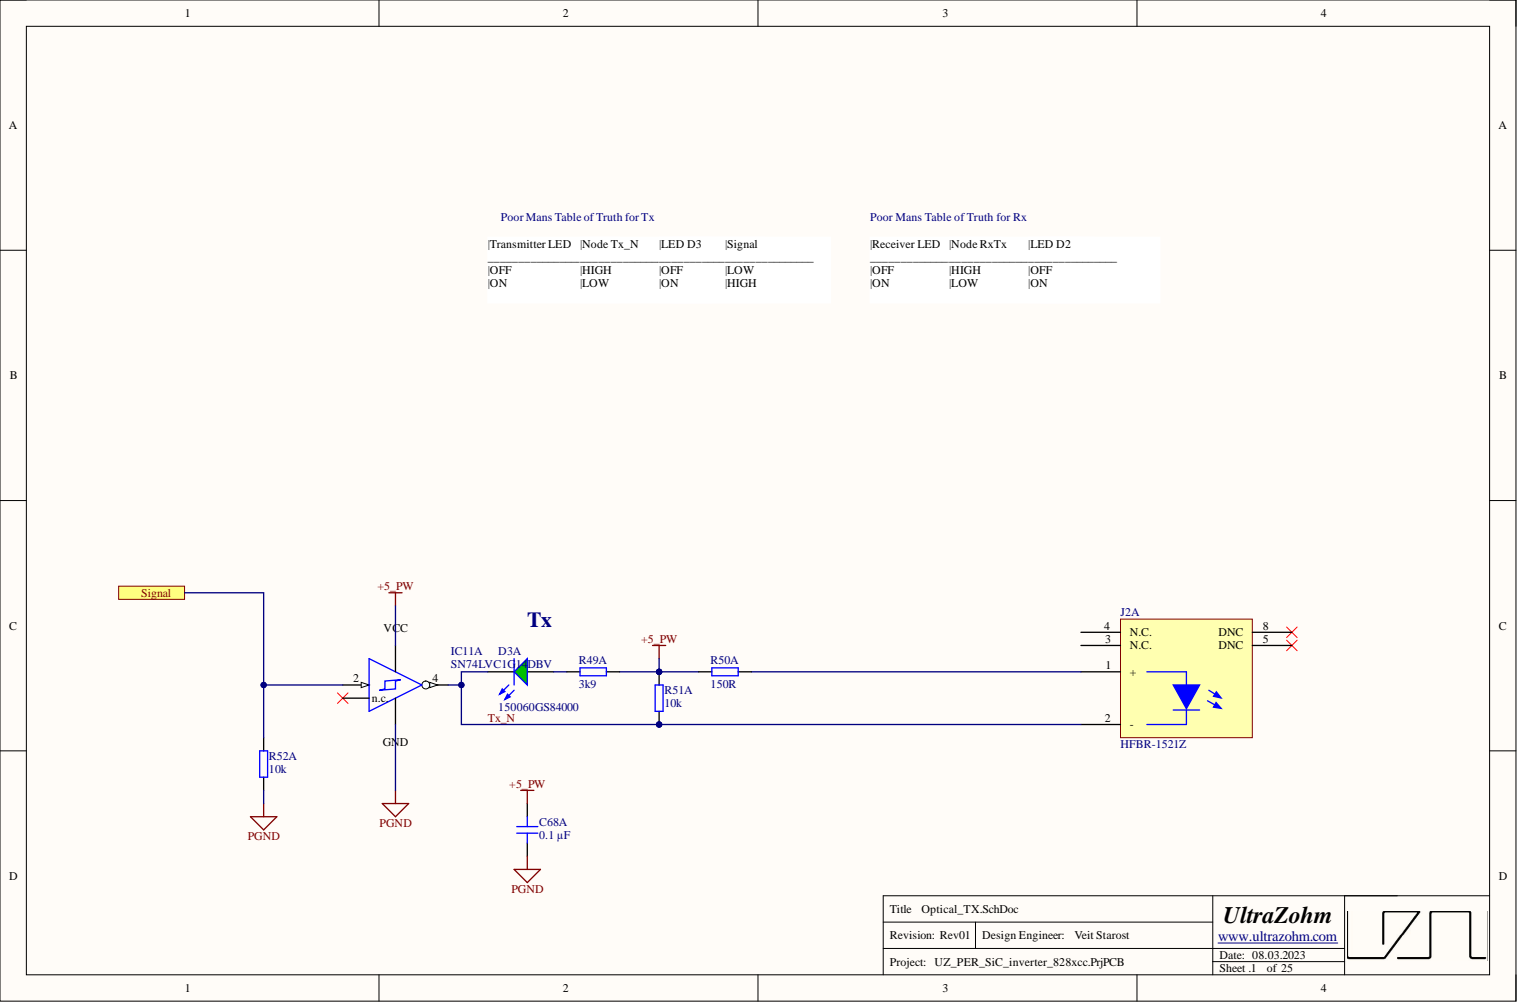
[picture p7: page 2]

Rev i s i o n :

Dat e : 8.0 .

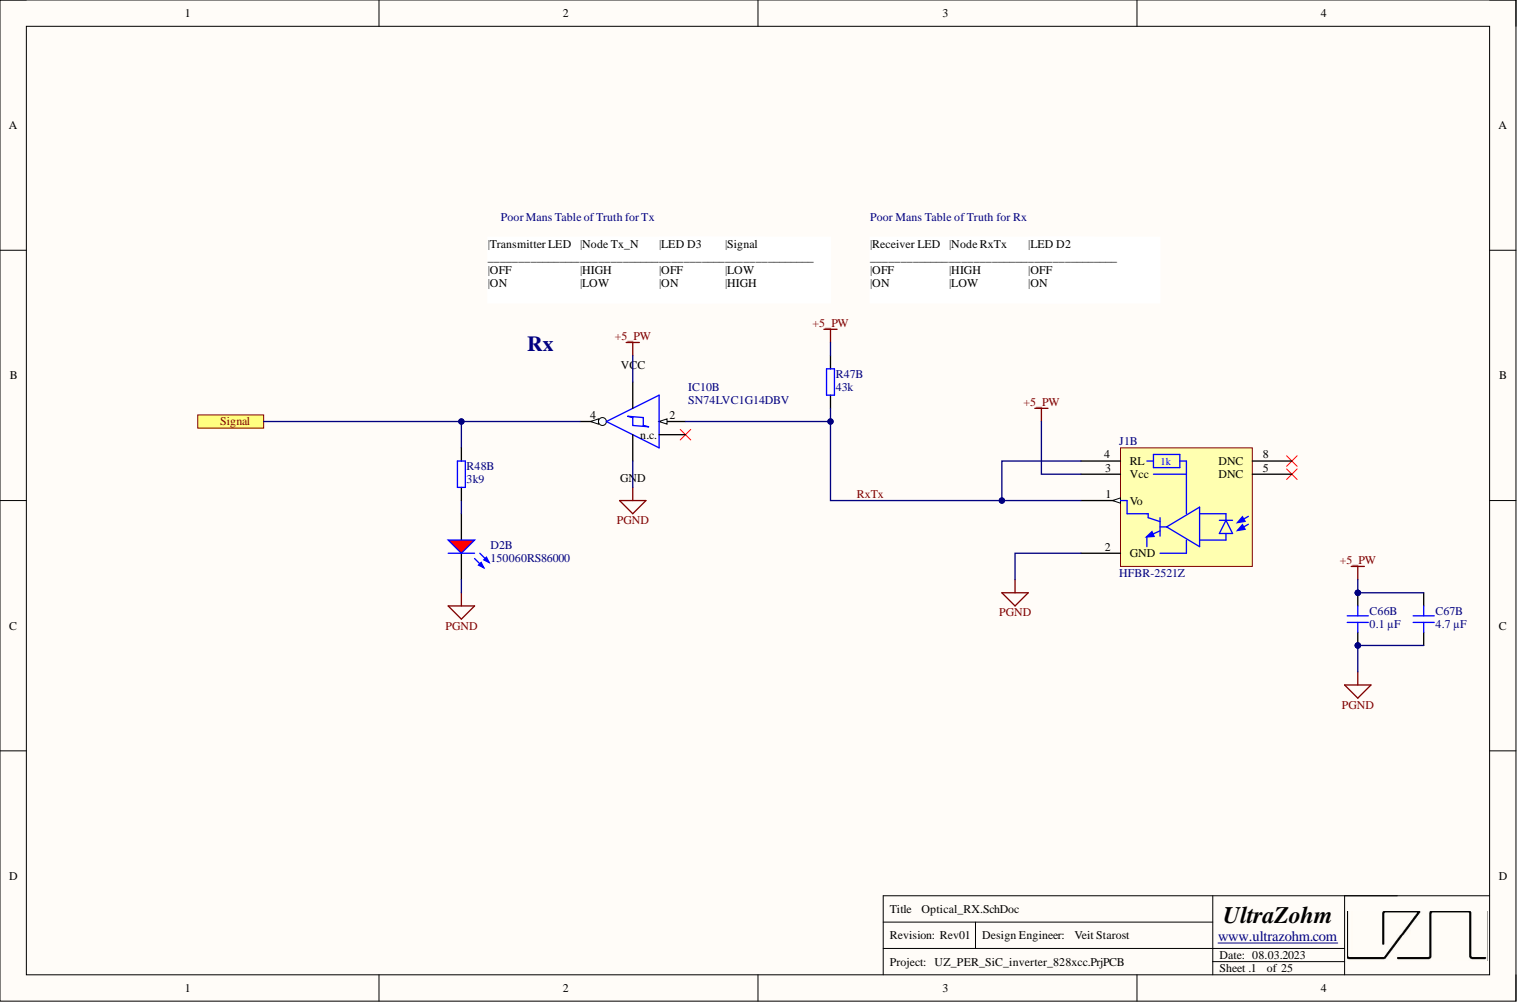
[picture p8: page 3]

Poor Mans Table of Truth for Tx

Poor Mans Table of Truth for Rx

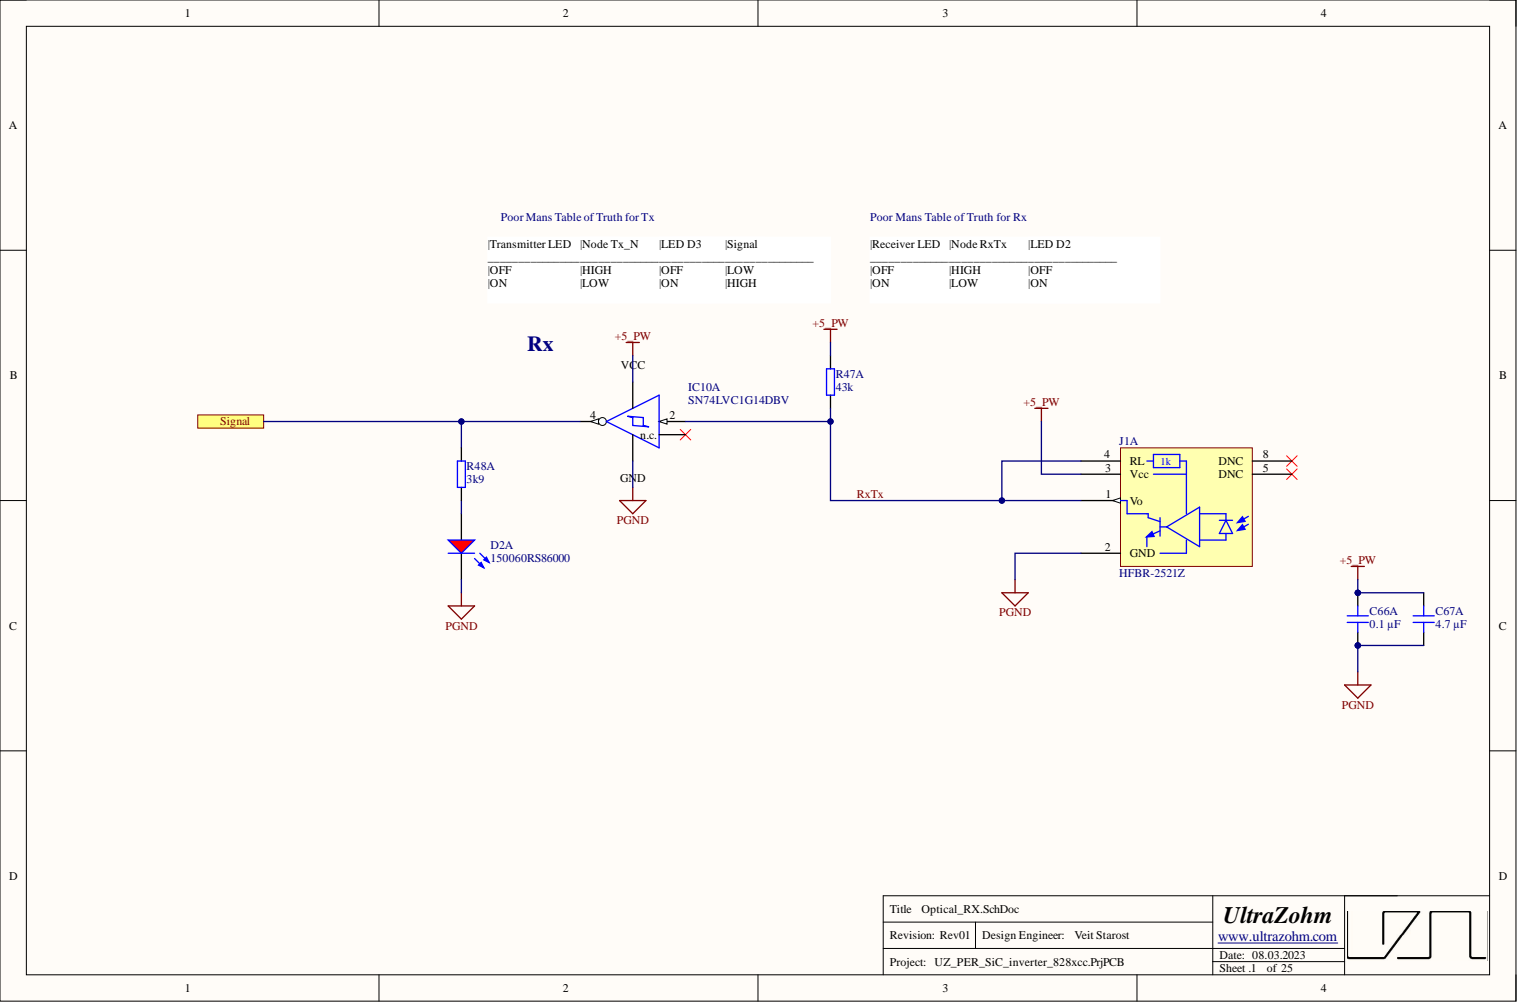
[picture p9: page 4]

Poor Mans Table of Truth for Tx

Poor Mans Table of Truth for Rx

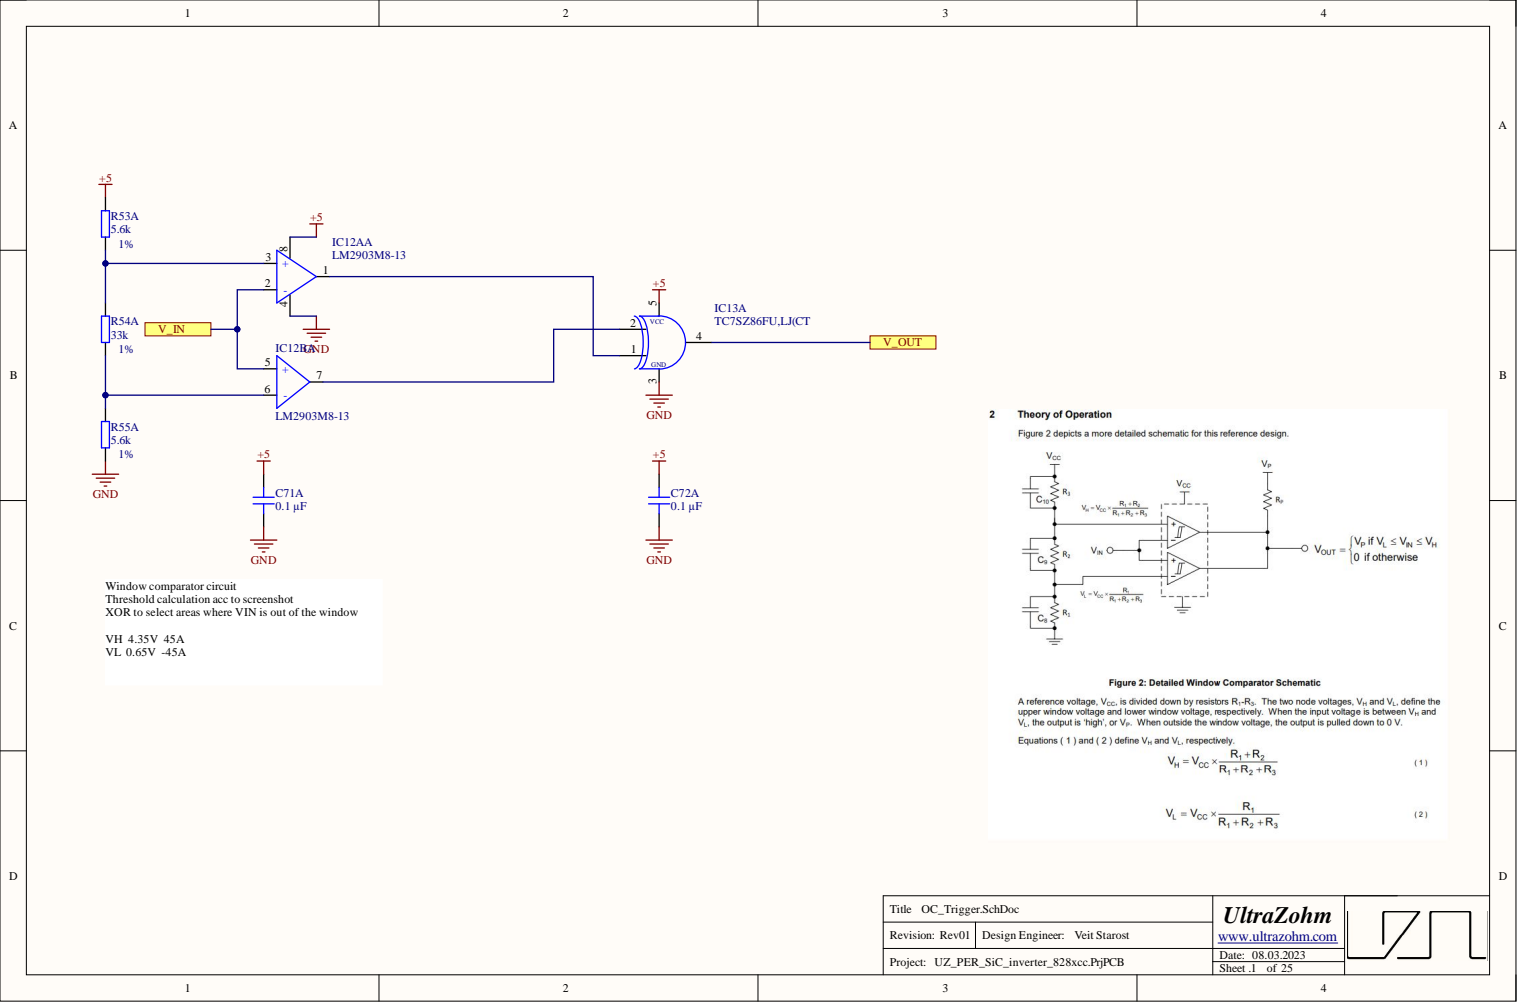
[picture p10: page 5]

Window comparator circuit
Threshold calculation acc to screenshot
XOR to select areas where VIN is out of the window

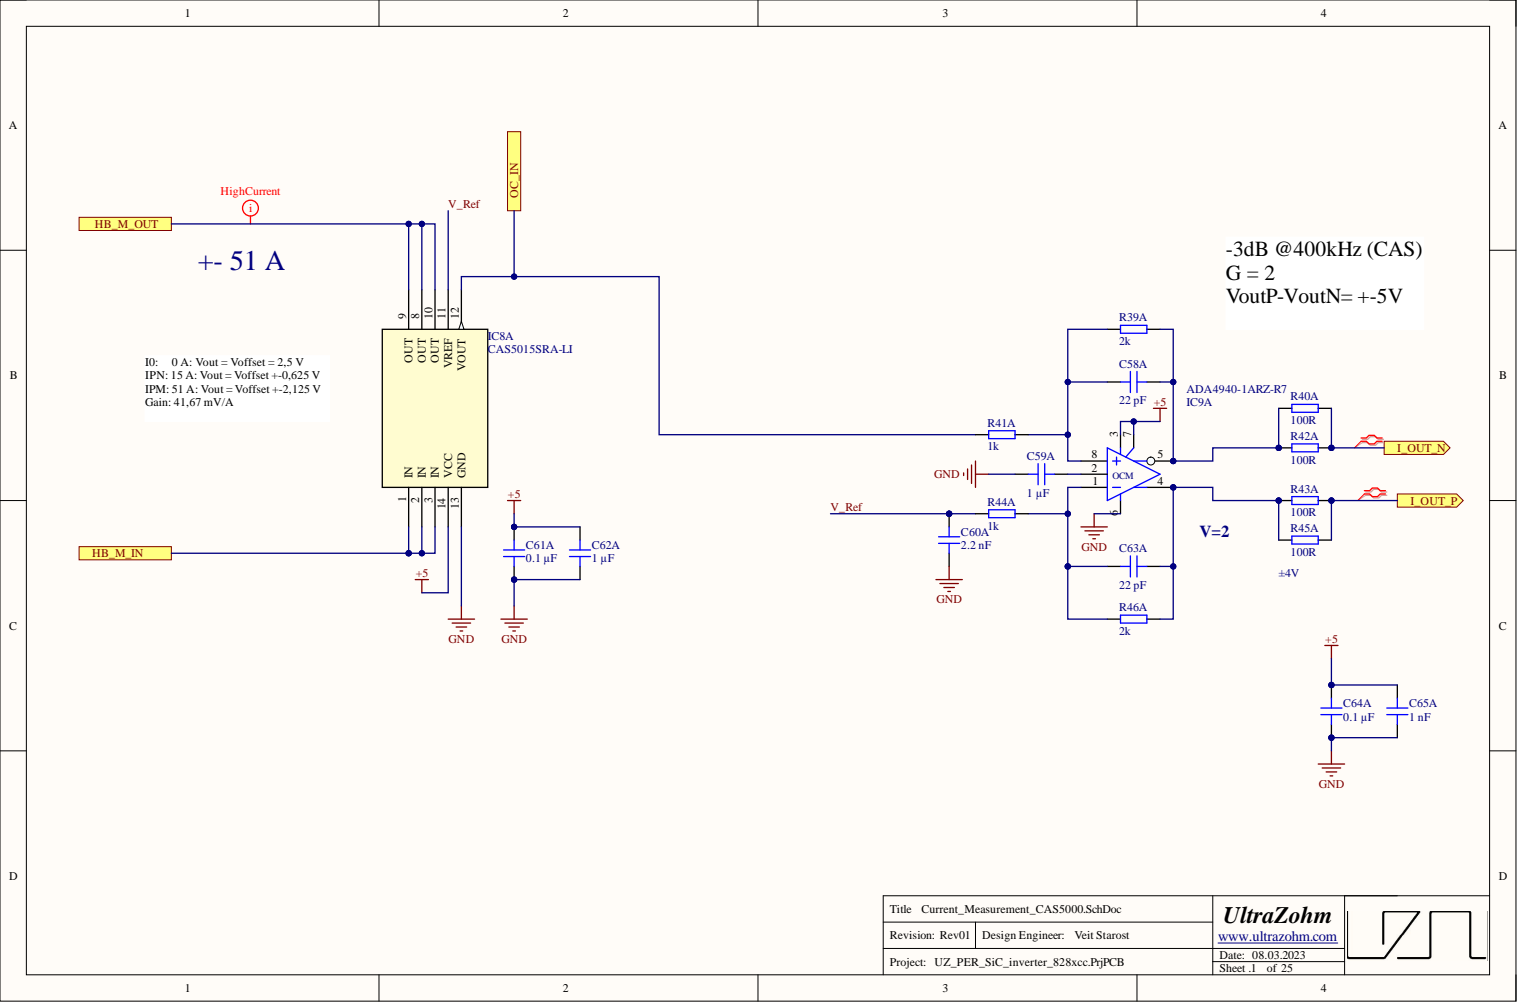
[picture p11: page 6]

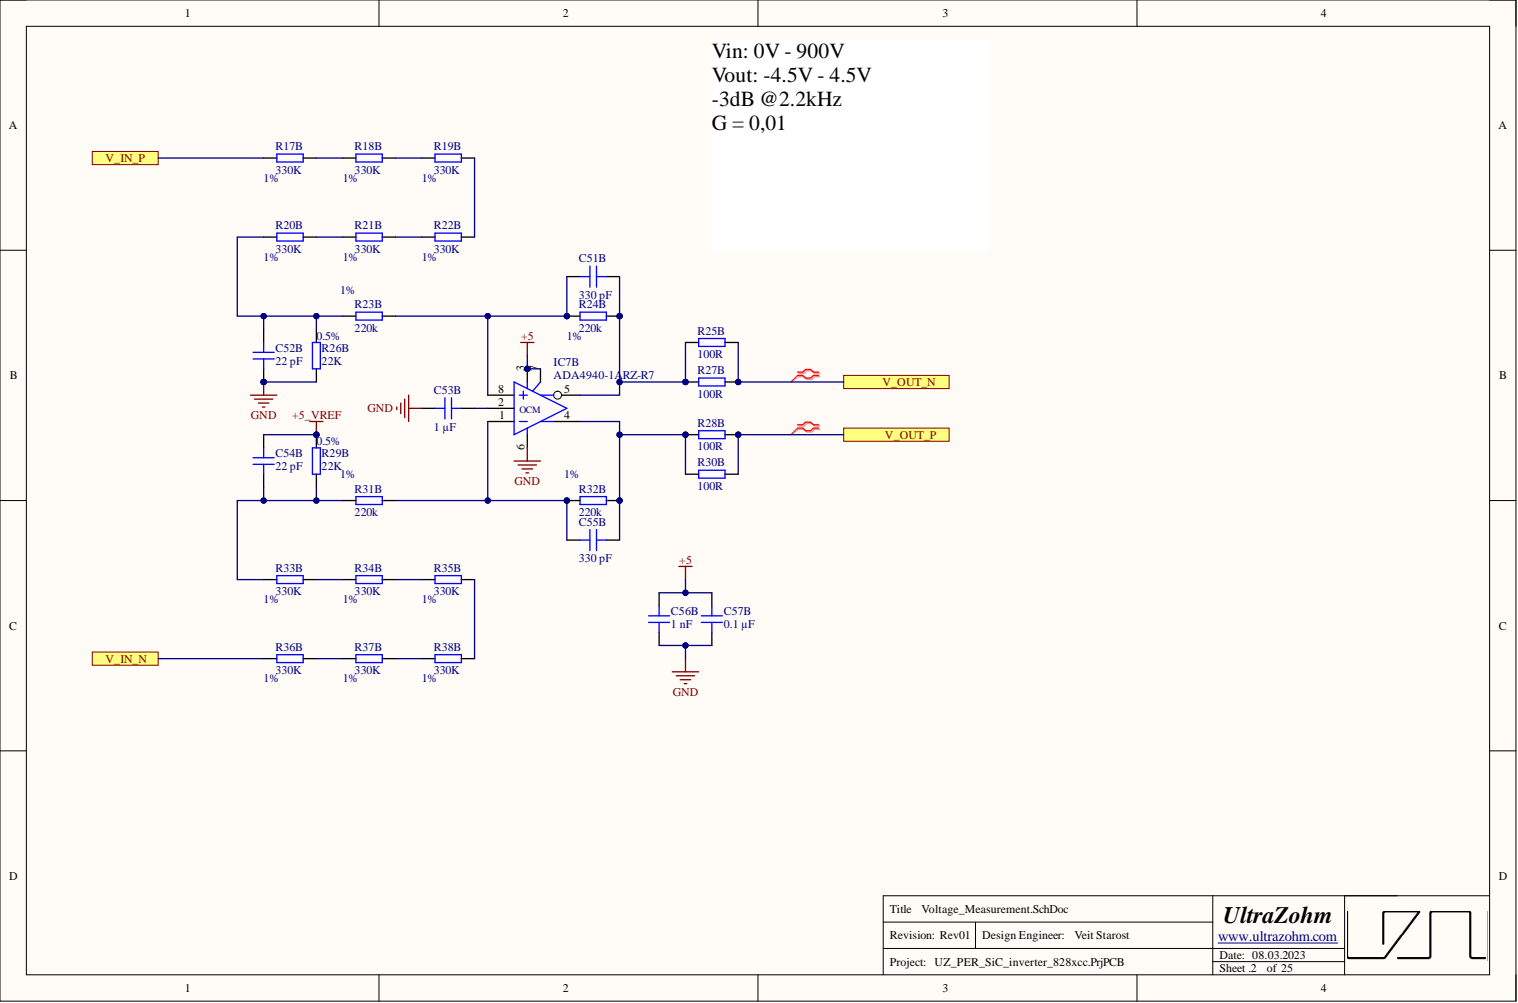
[picture p12: page 7]

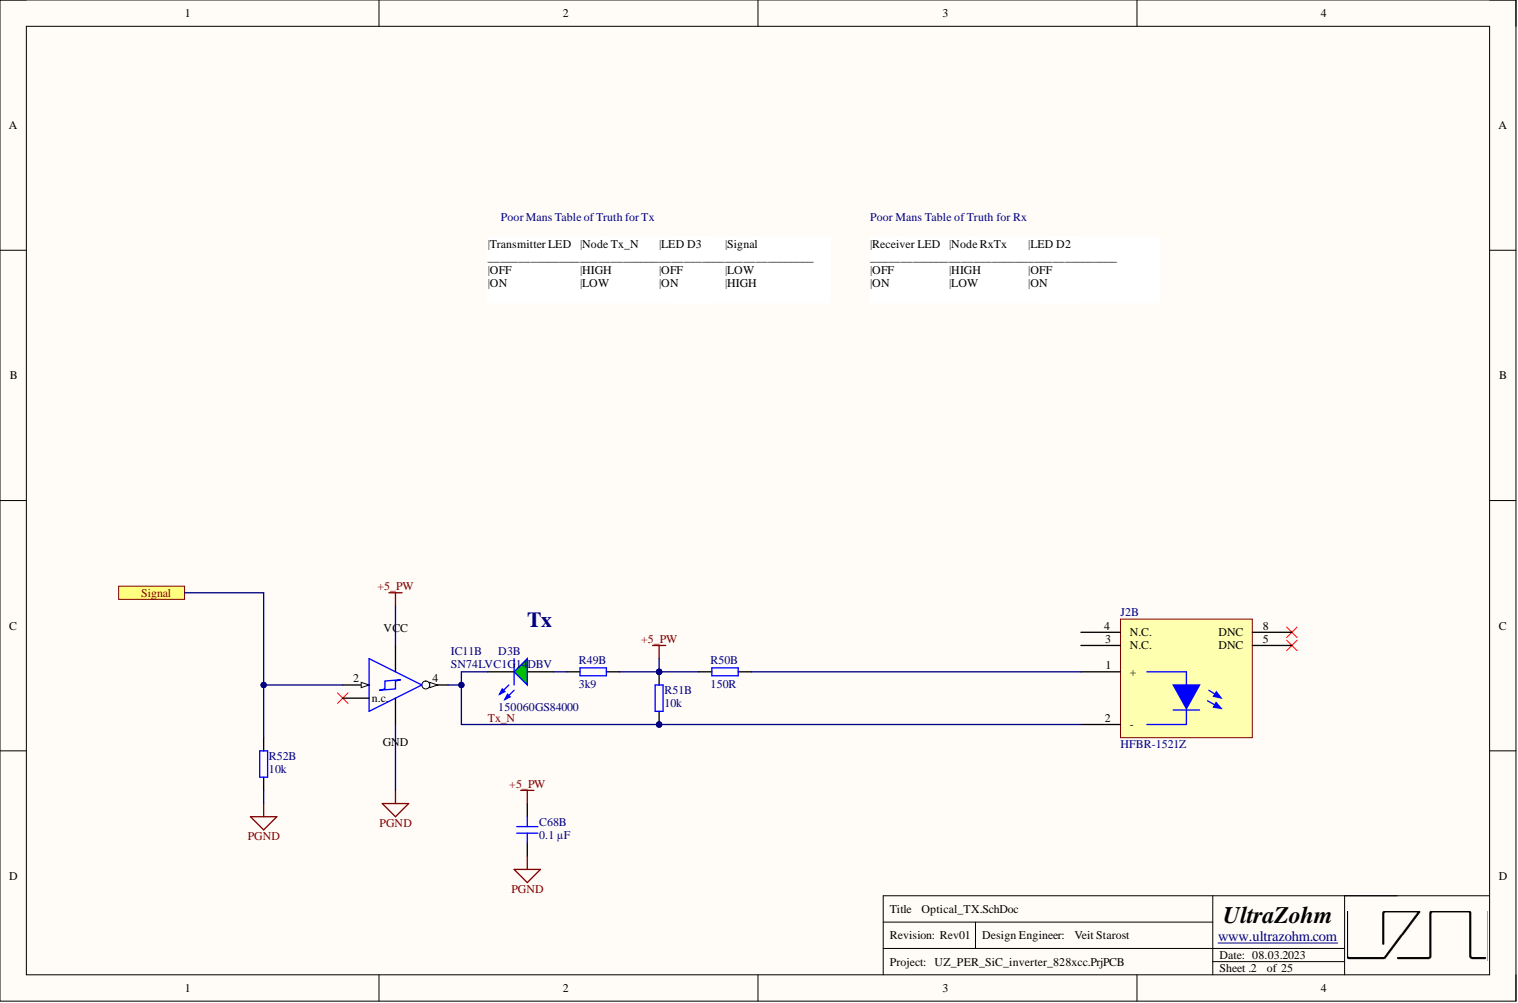
[picture p13: page 8]

Rev i s i o n :

Dat e : 8.0 .

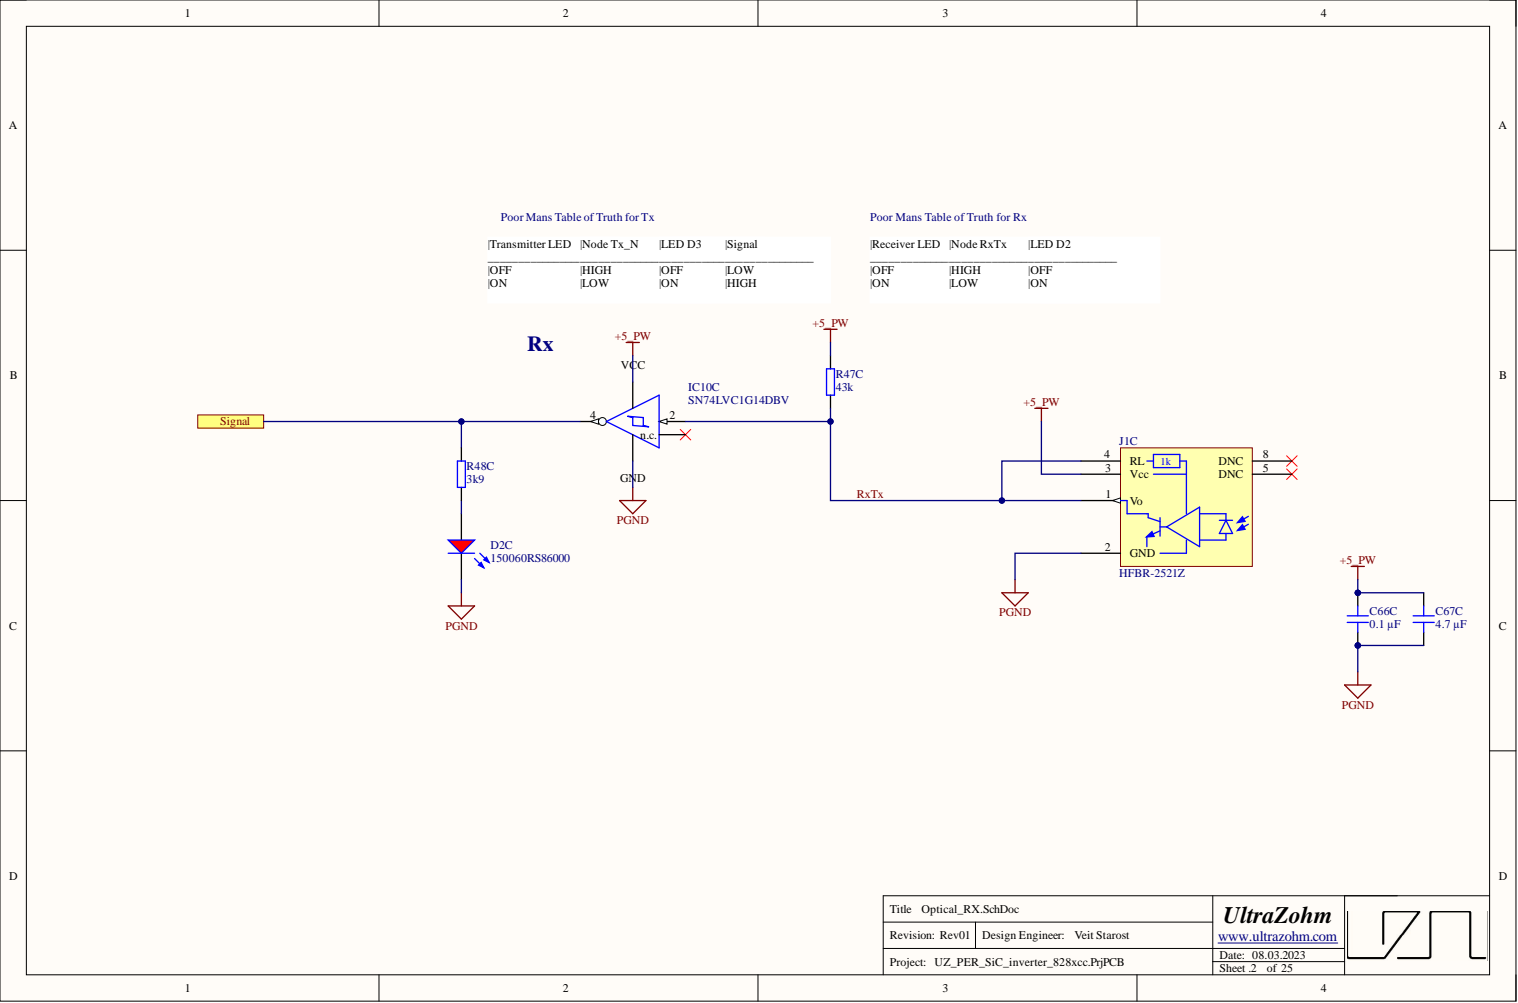
[picture p14: page 9]

Poor Mans Table of Truth for Tx

Poor Mans Table of Truth for Rx

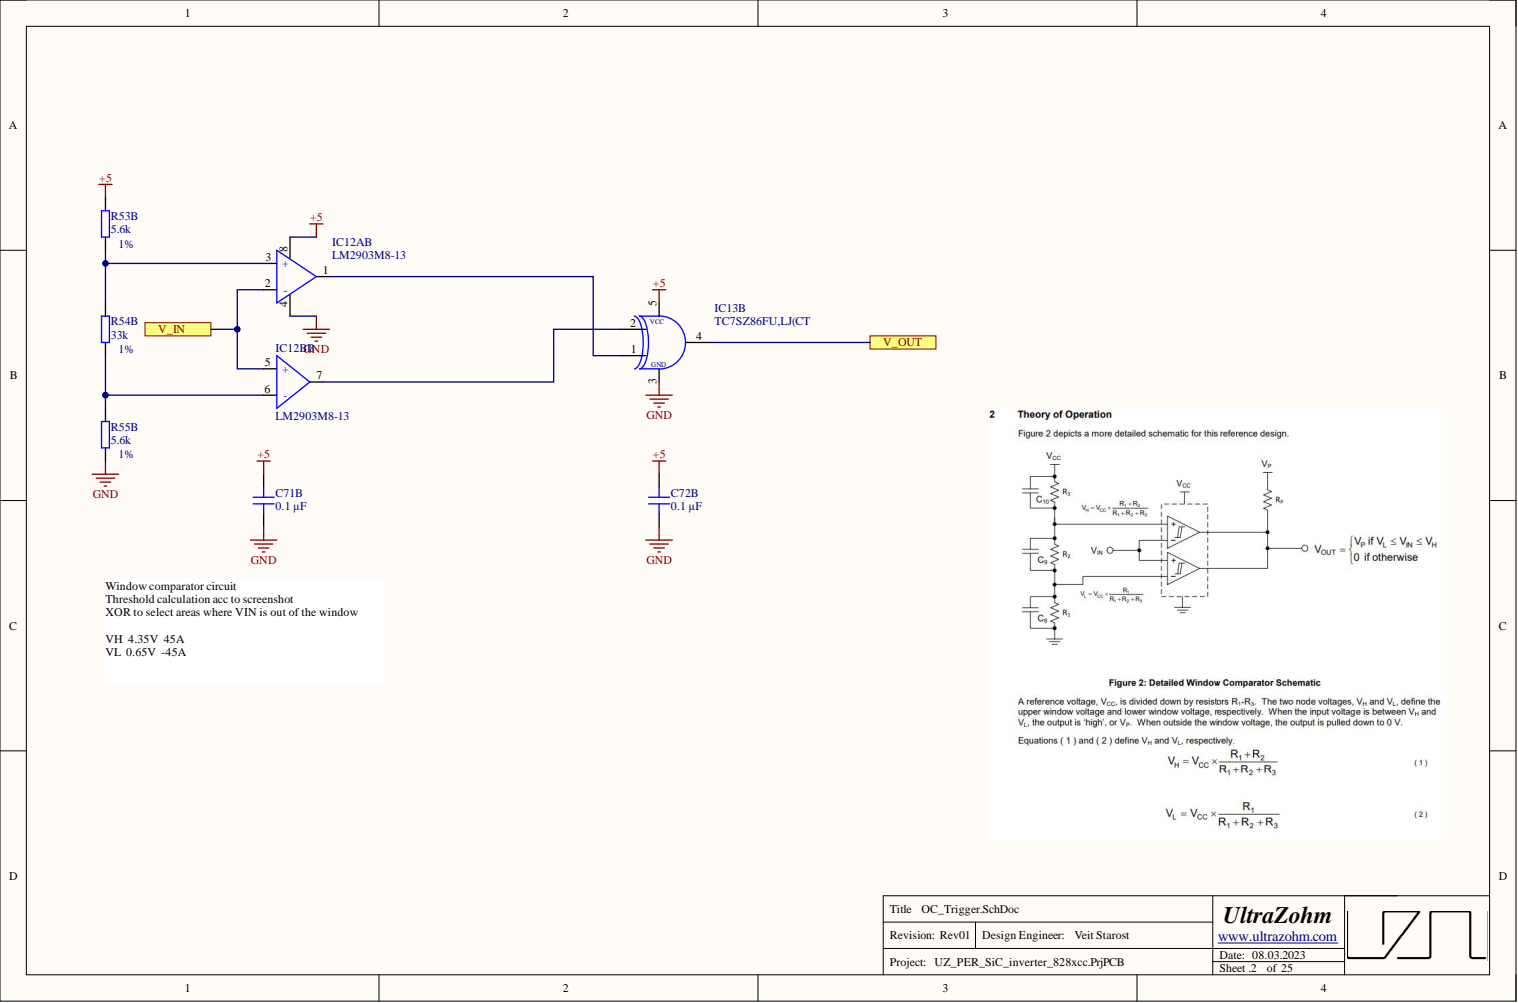
[picture p15: page 10]
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

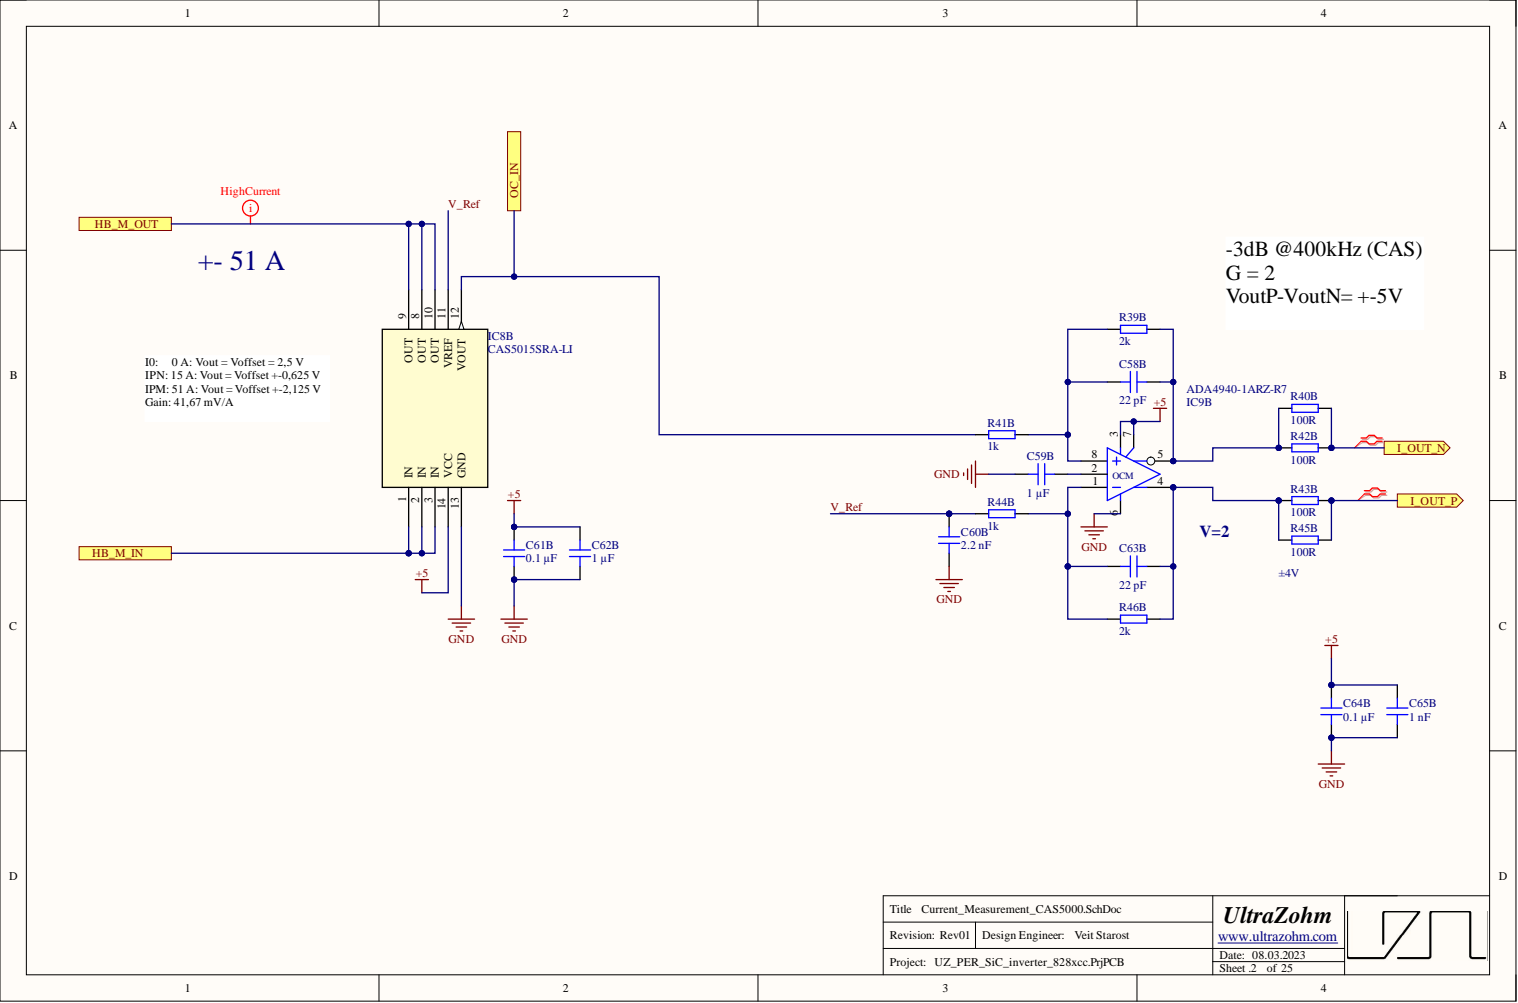
[picture p16: page 11]

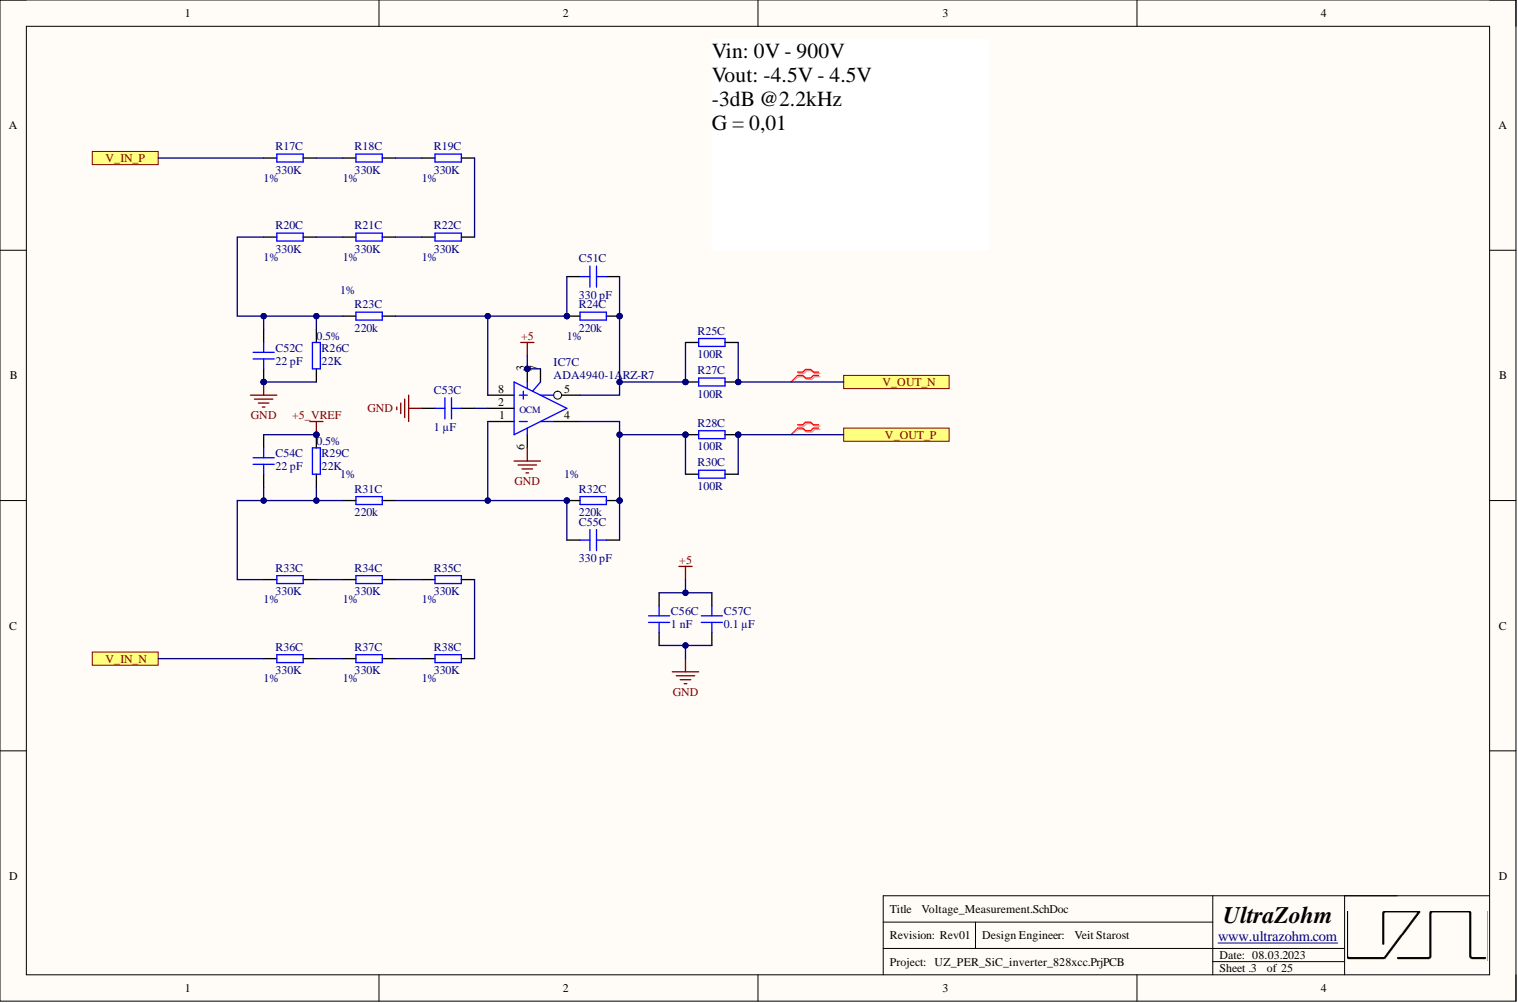
[picture p17: page 12]

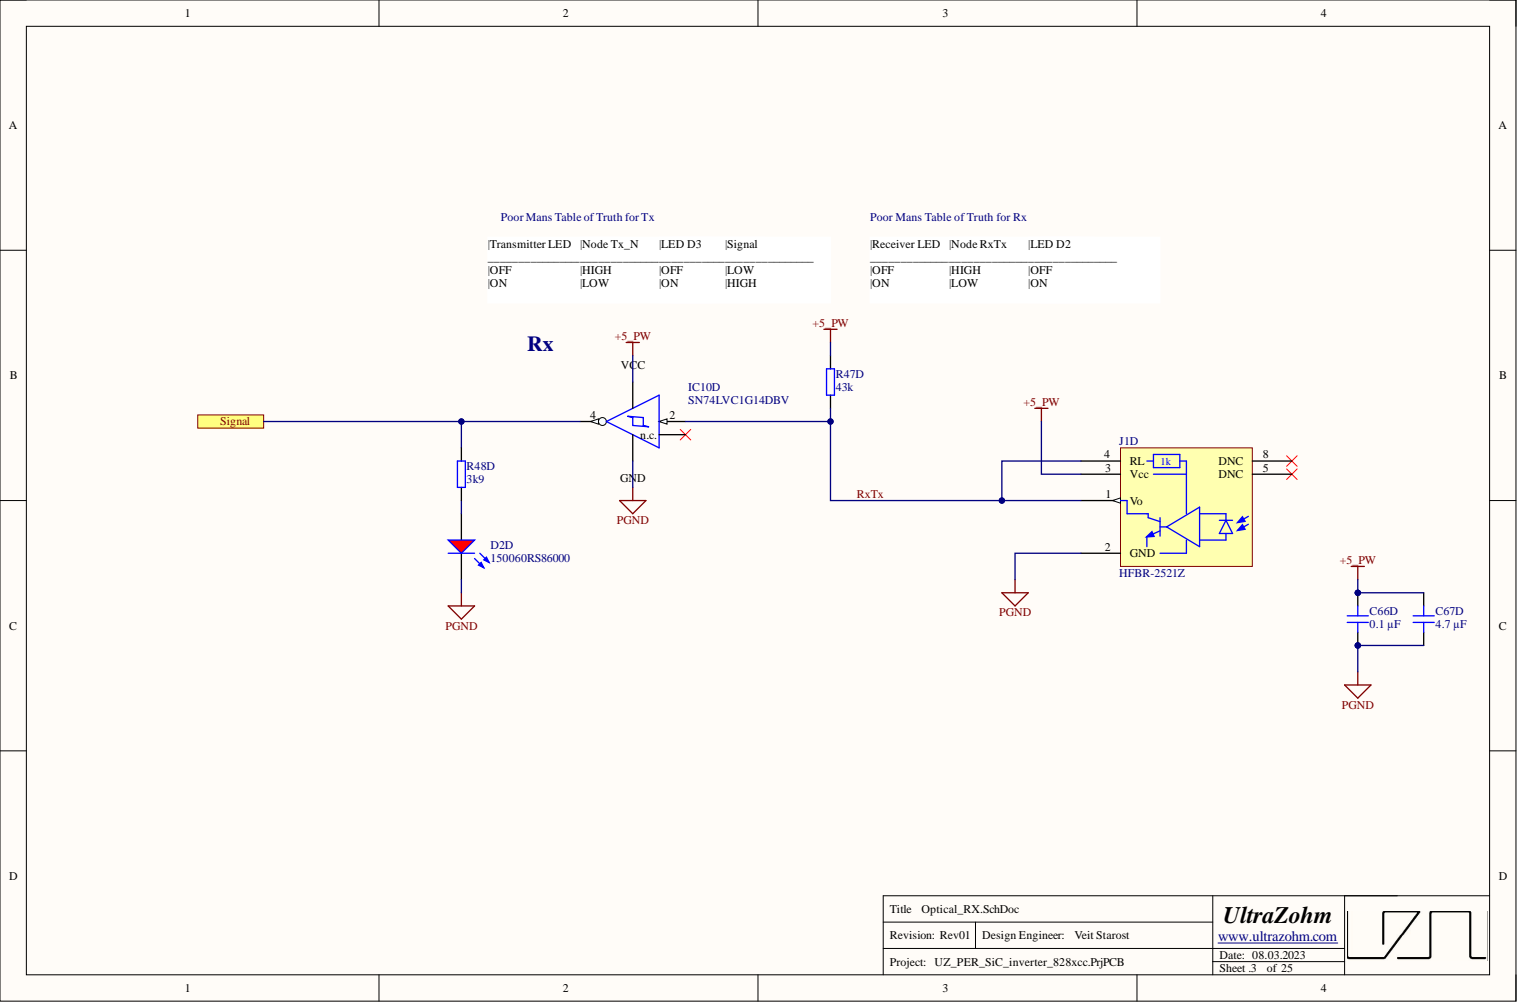
[picture p18: page 13]

Rev i s i o n :

Dat e : 8.0 .

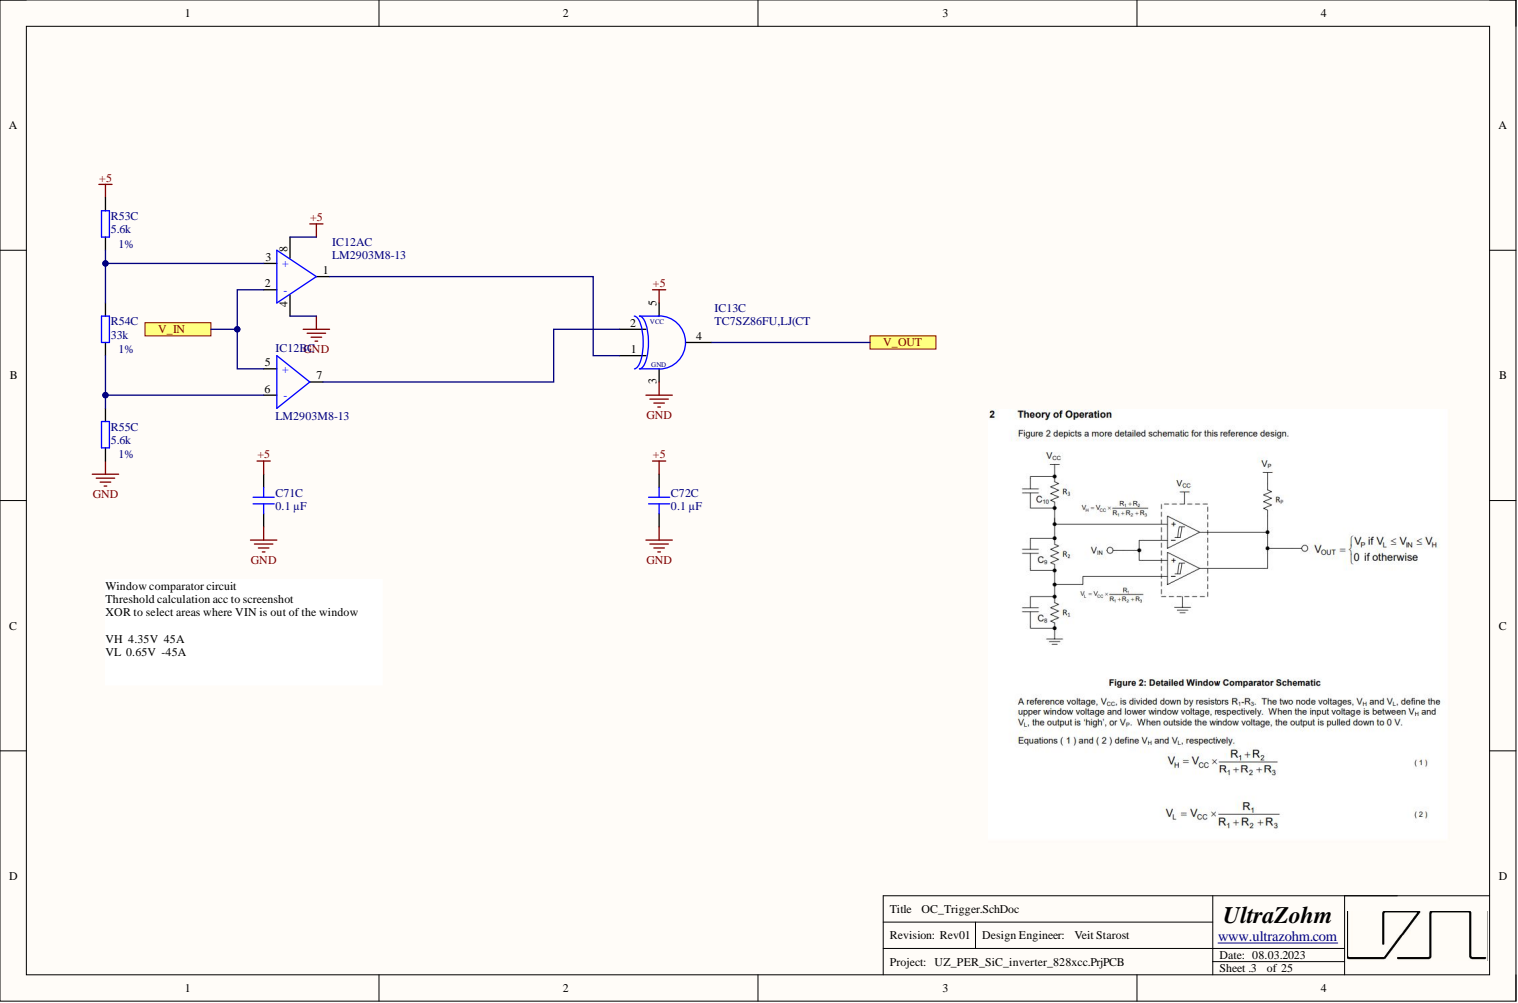
[picture p19: page 14]
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

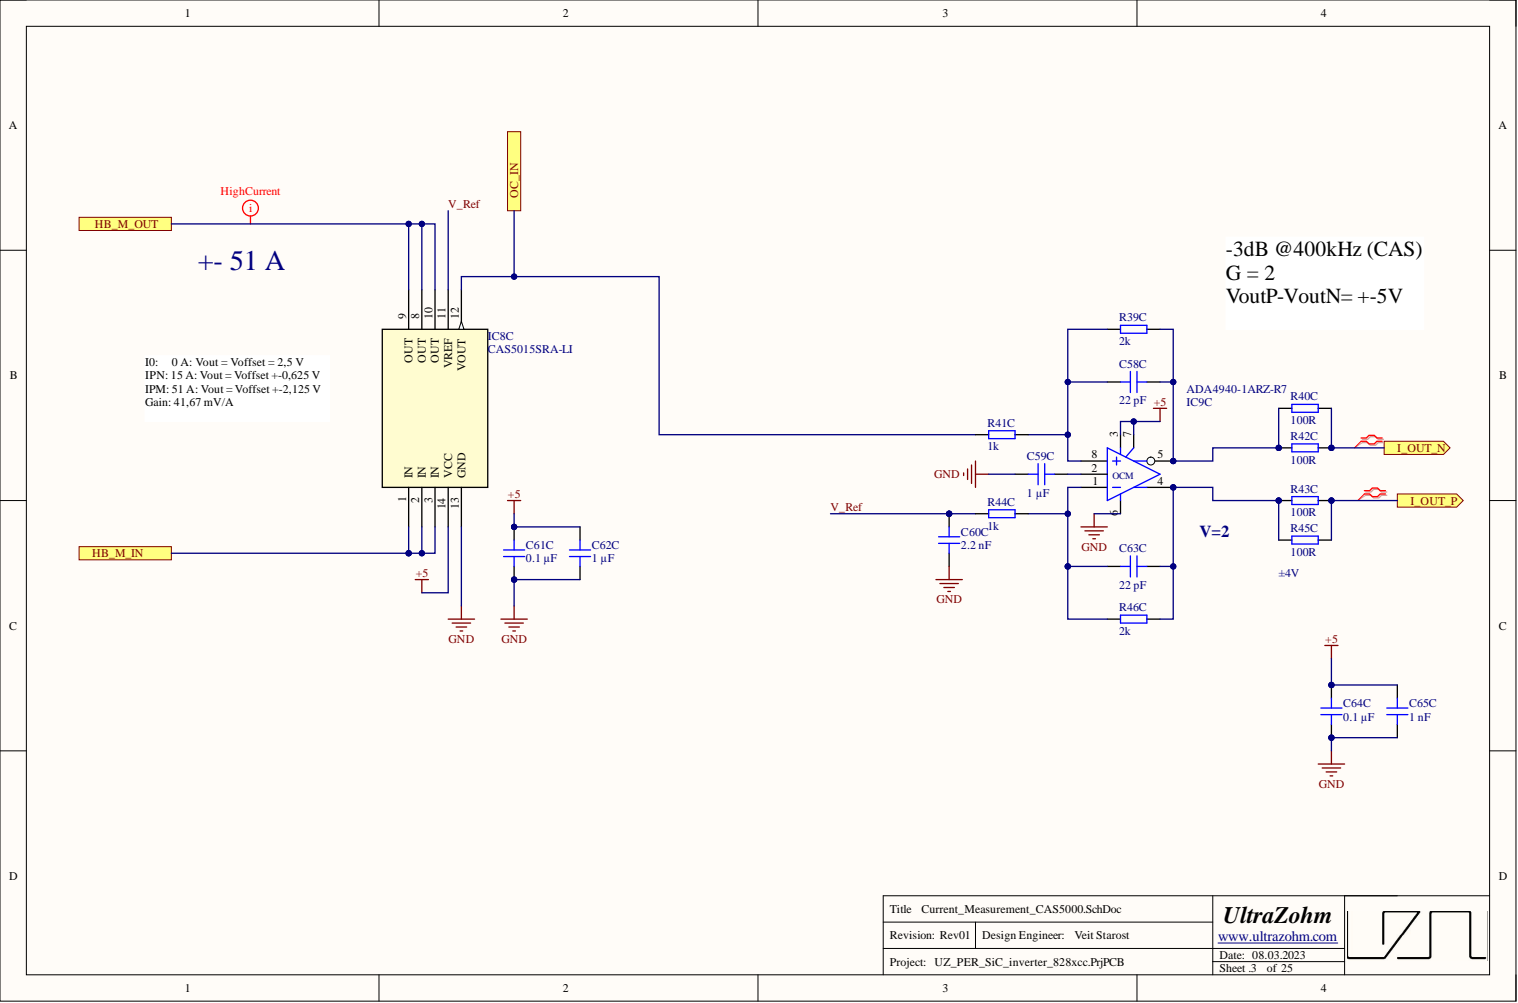
[picture p20: page 15]

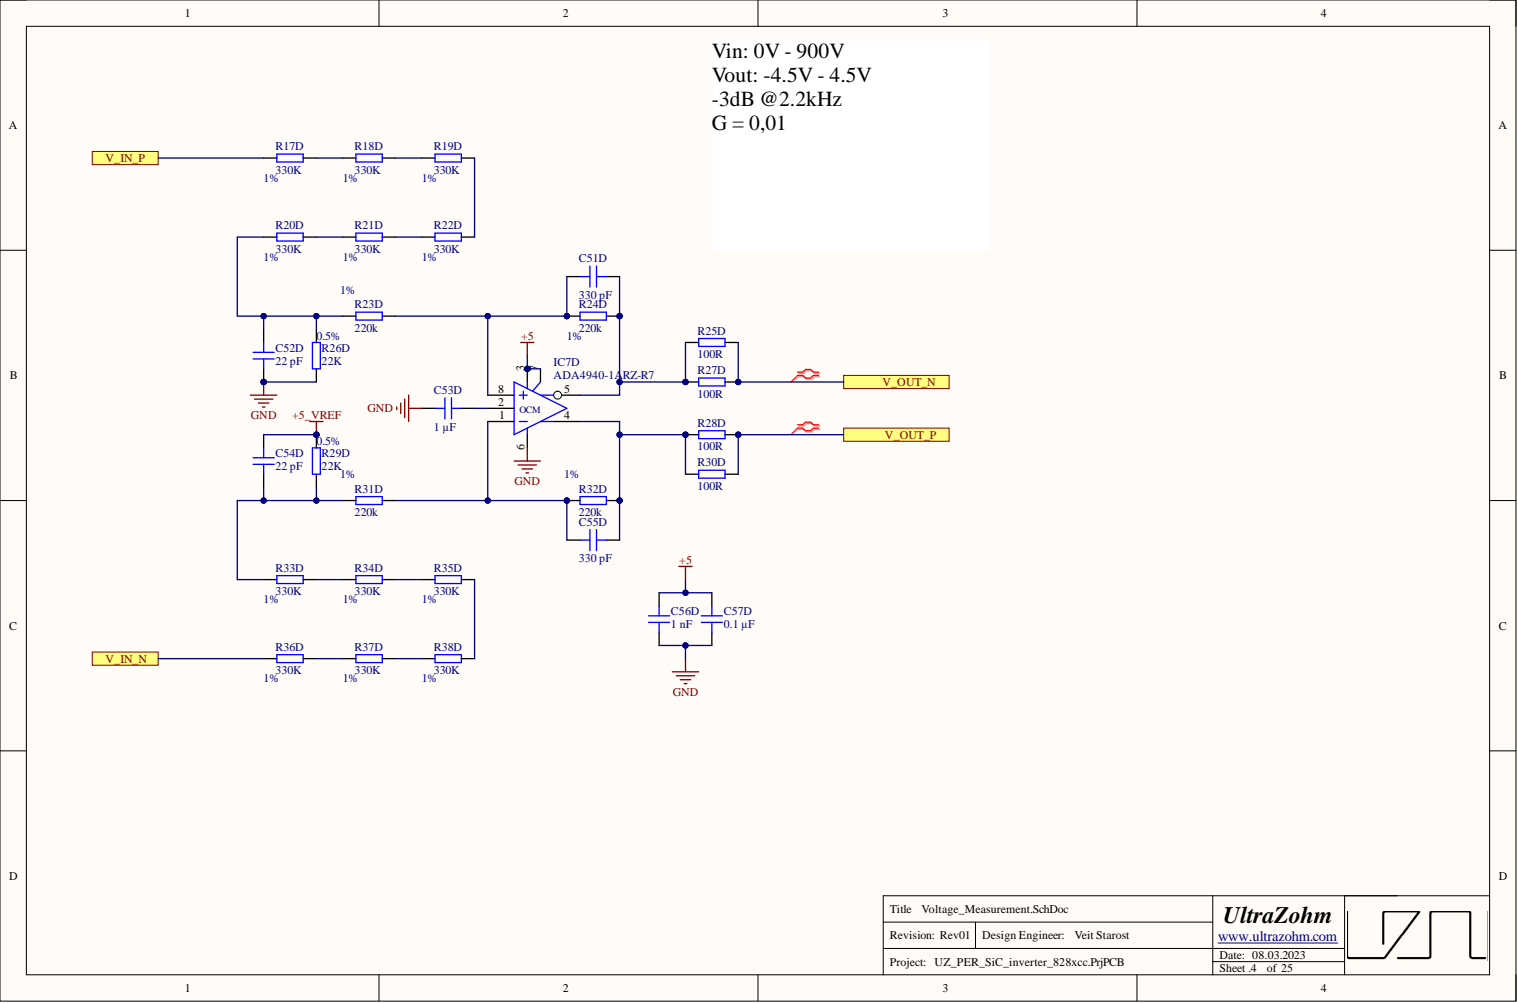
[picture p21: page 16]

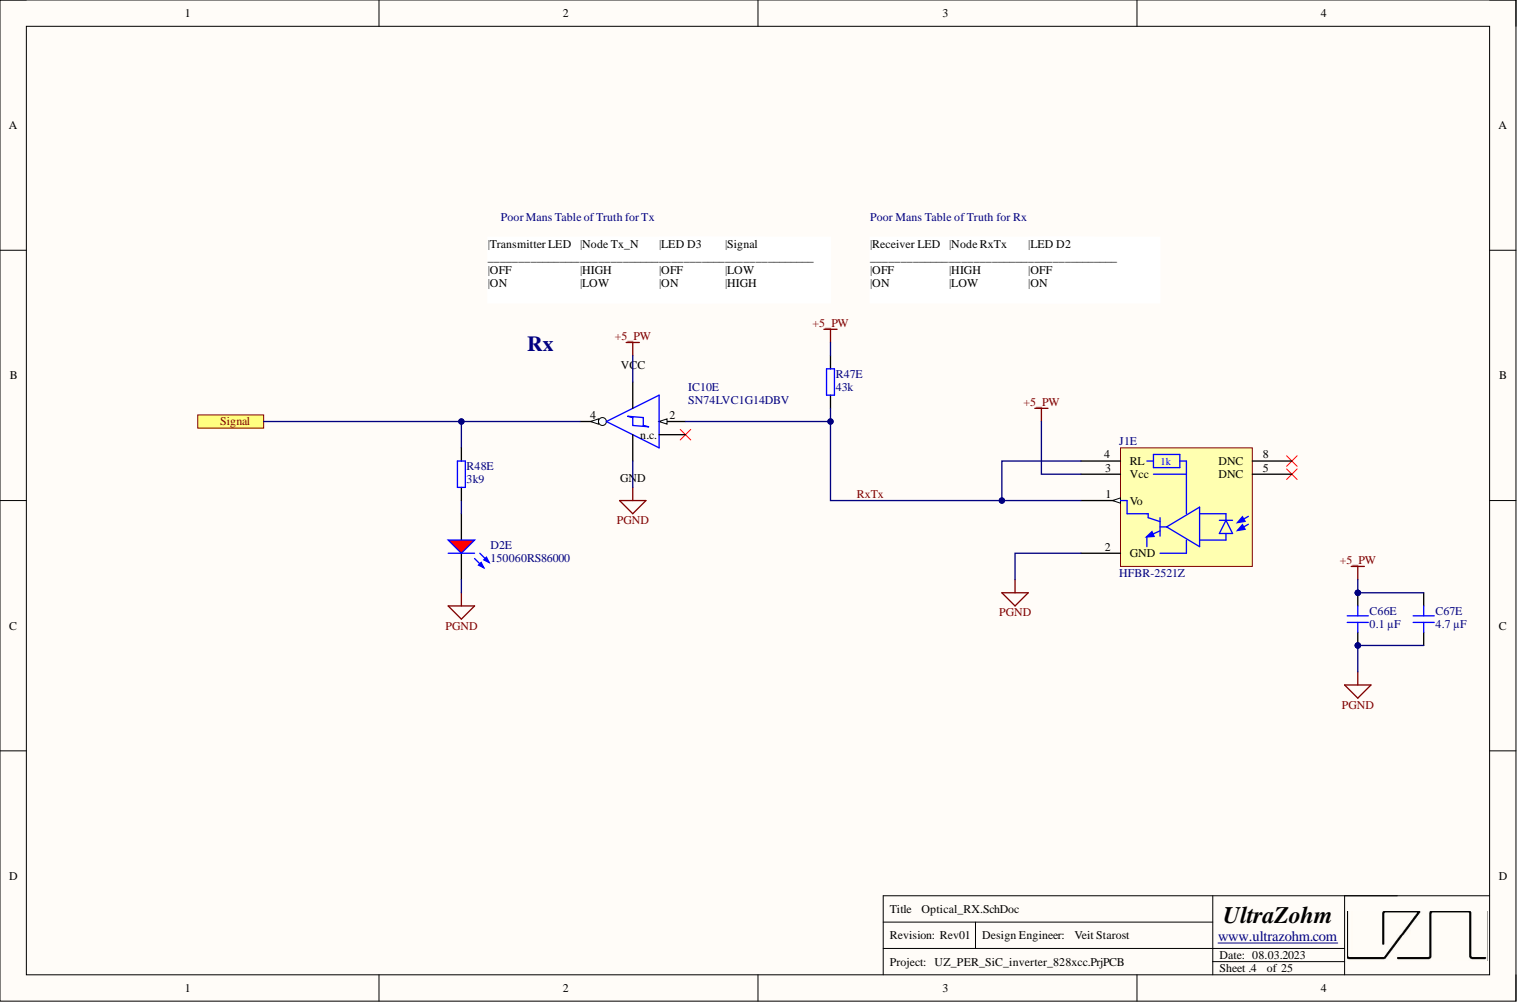
[picture p22: page 17]

Rev i s i o n :

Dat e : 8.0 .

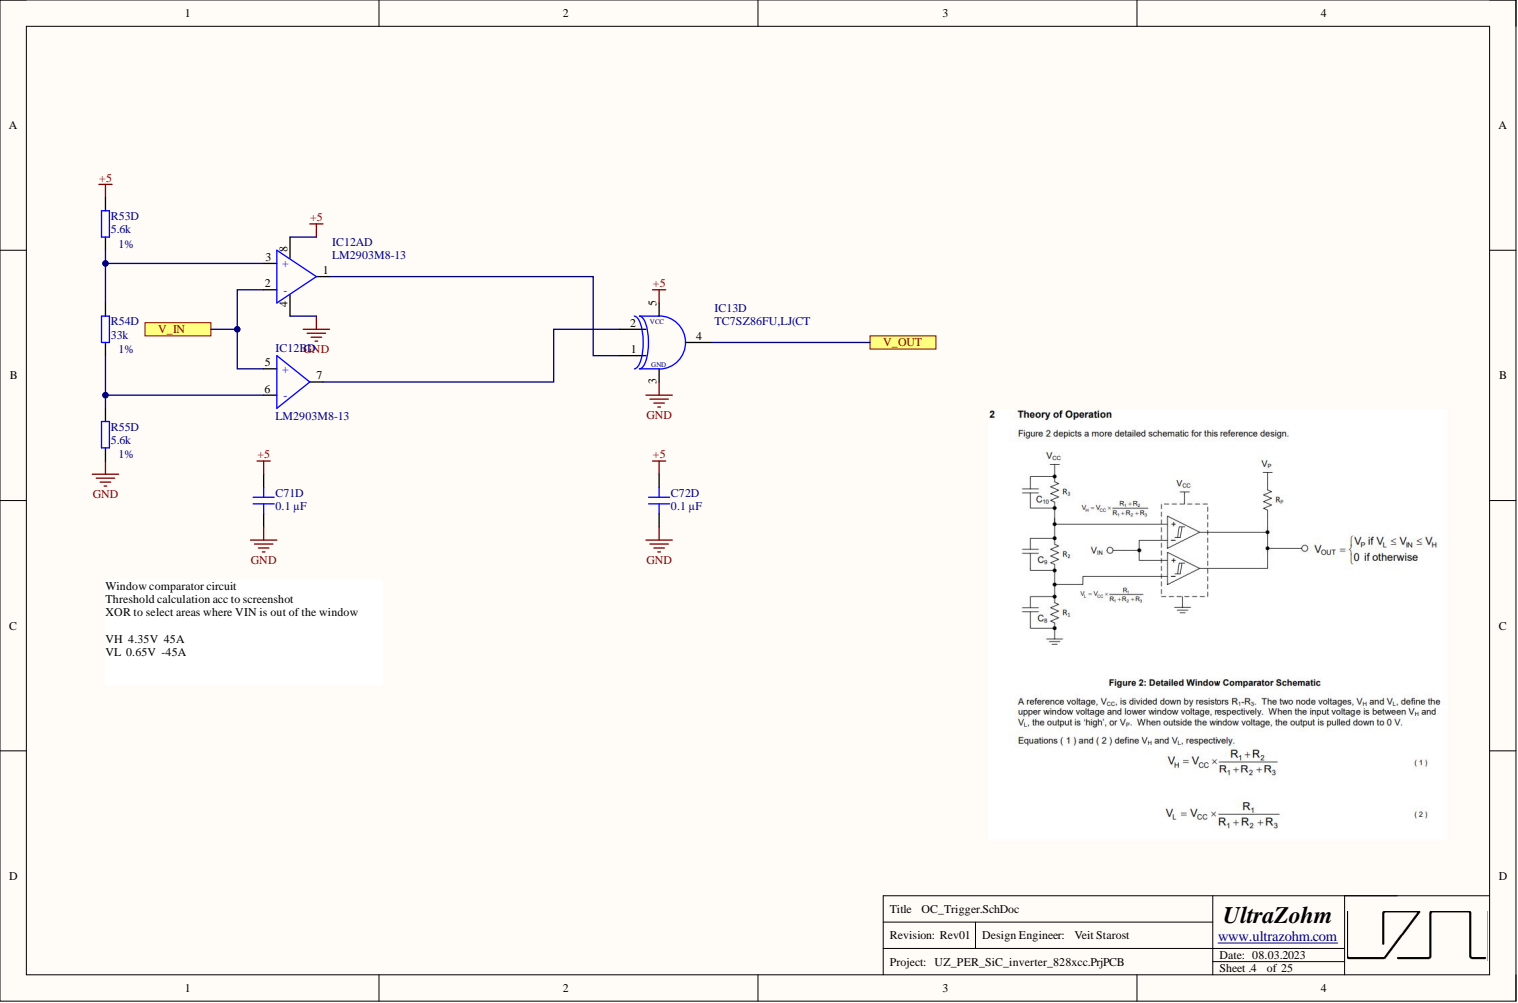
[picture p23: page 18]
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

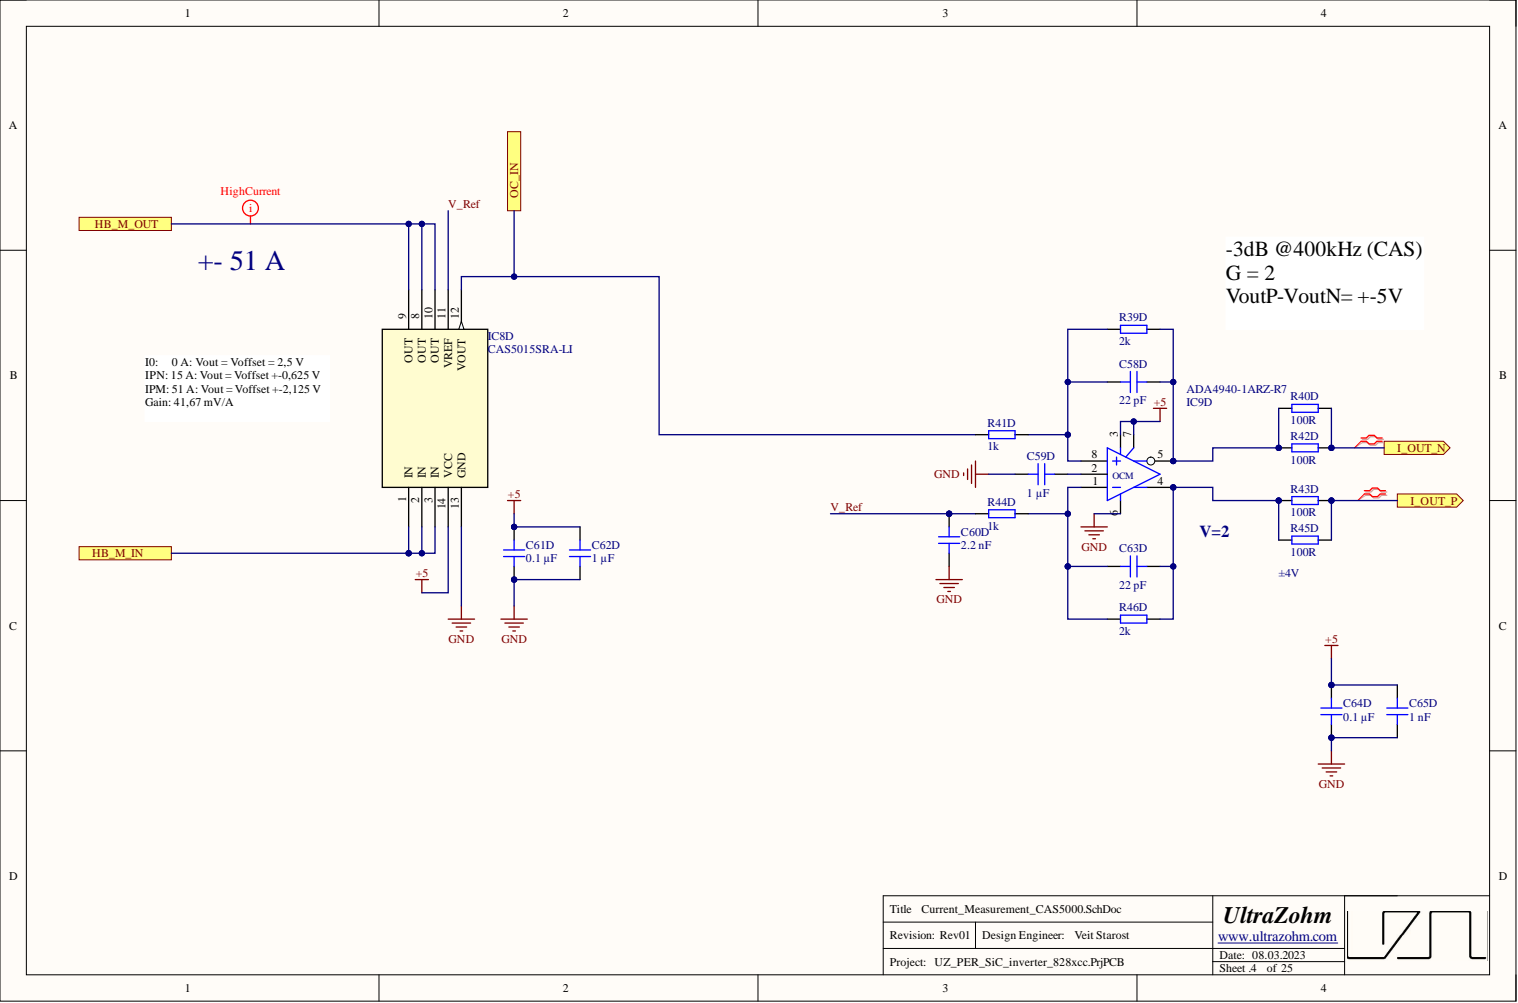
[picture p24: page 19]

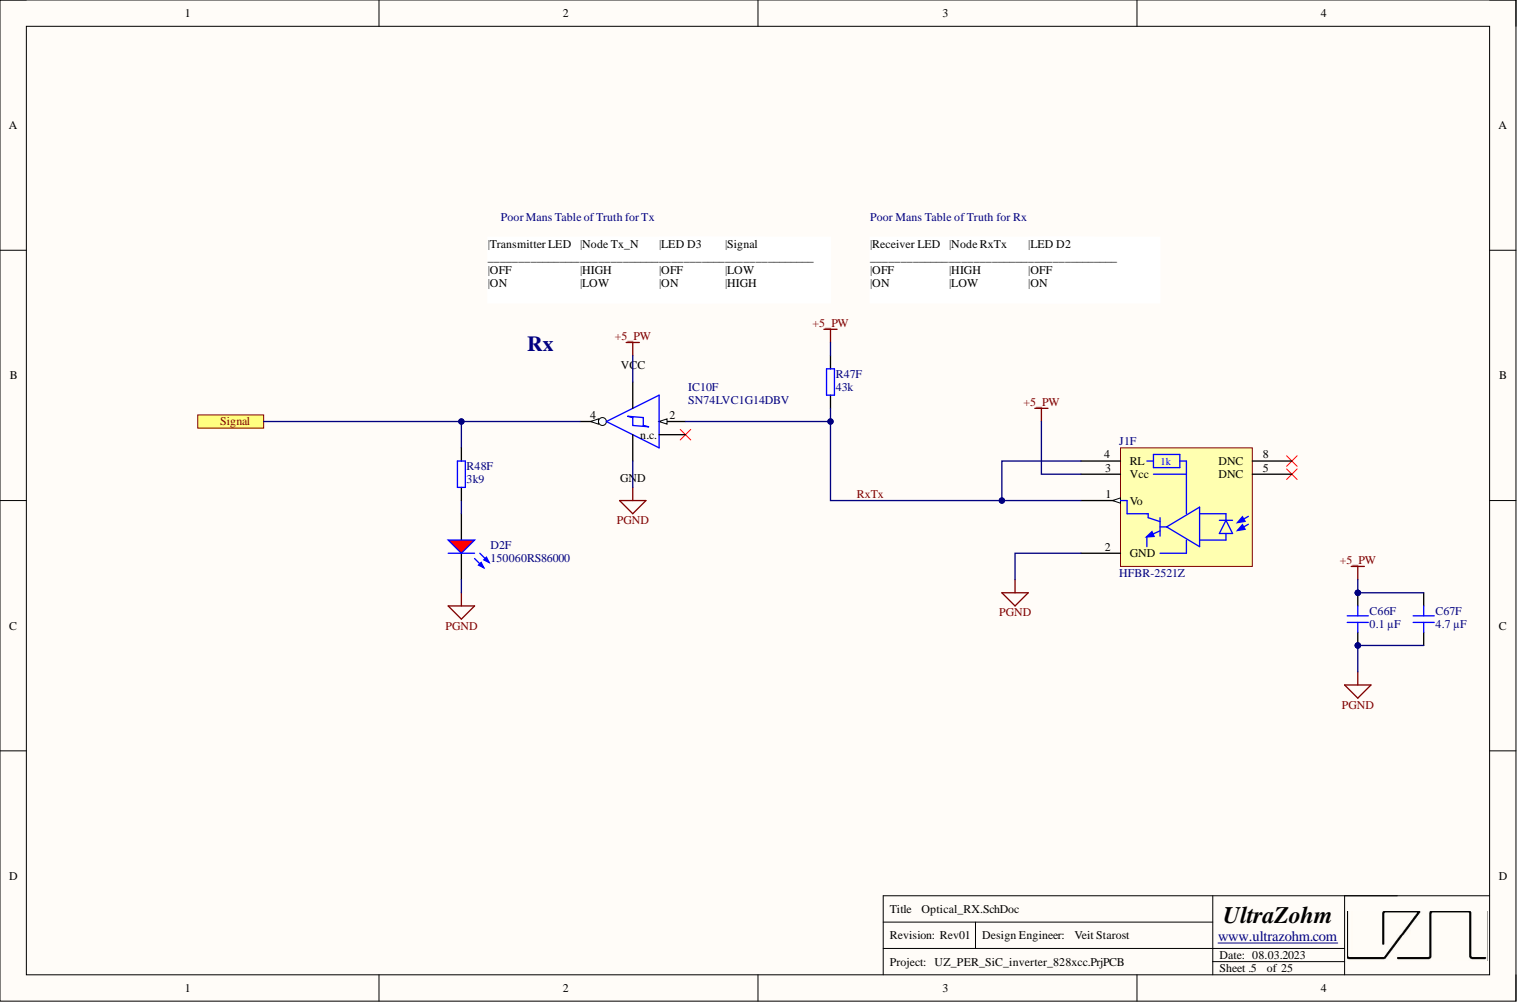
[picture p25: page 20]

Rev i s i o n :

Dat e : 8.0 .

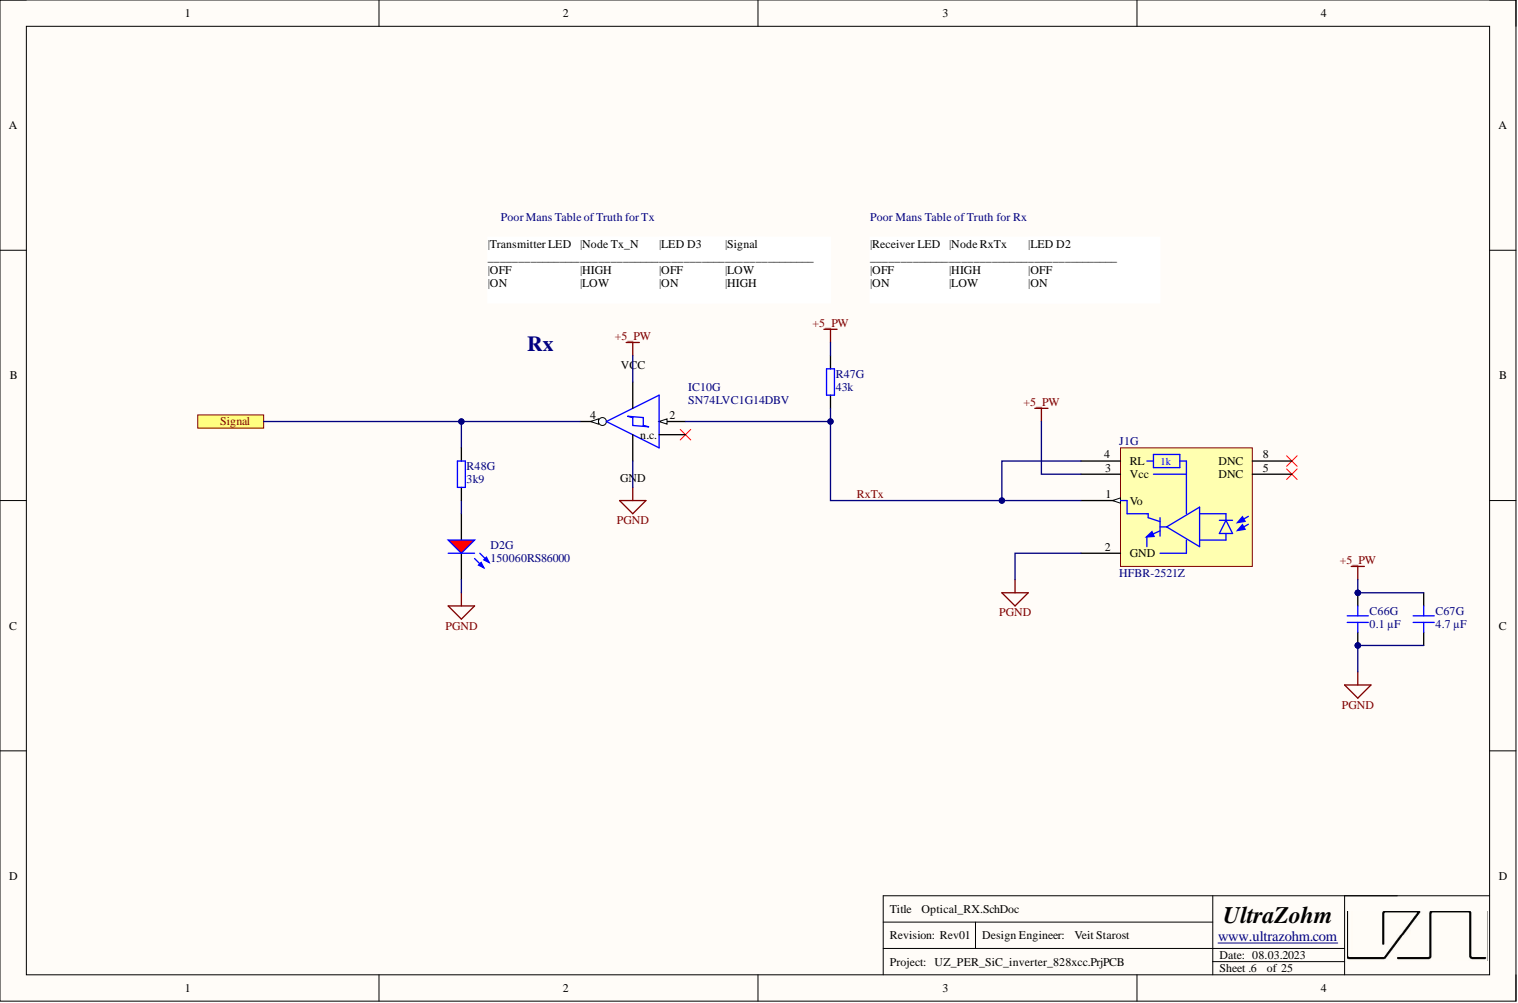
[picture p26: page 21]

Rev i s i o n :

Dat e : 8.0 .

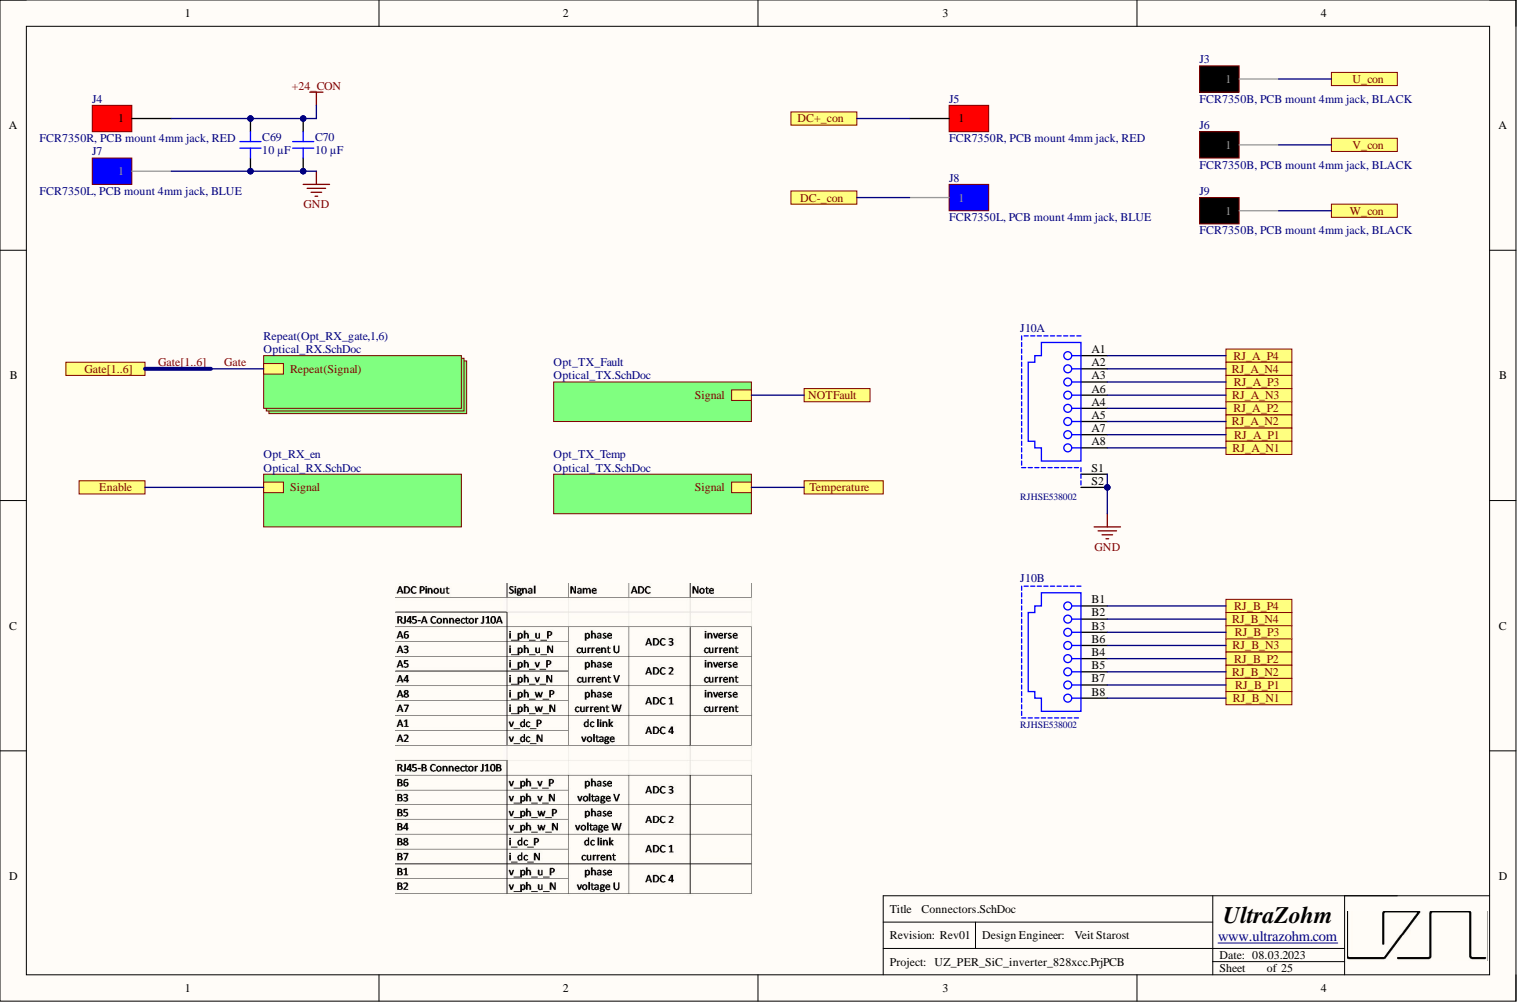
[picture p27: page 22]

FCR7350B, PCB mount 4mm jack, BLACK

FCR7350R, PCB mount 4mm jack, RED

FCR7350L, PCB mount 4mm jack, BLUE

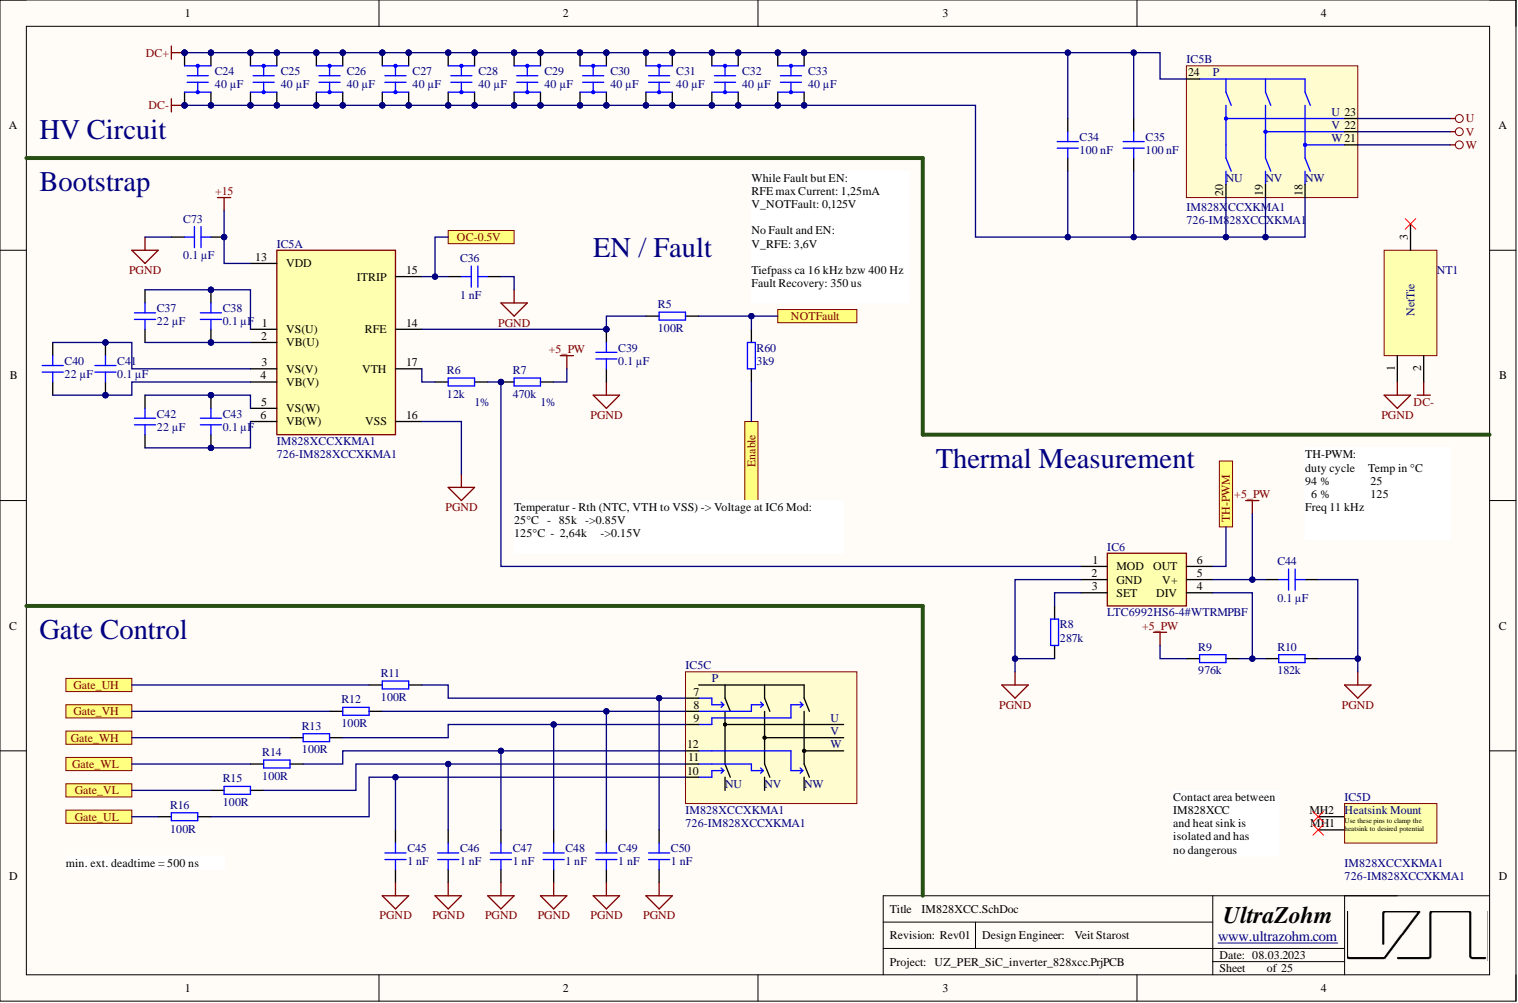
[picture p28: page 23]

V 22
W 21

While Fault but EN:
RFE max Current: 1,25mA
V_NOTFault: 0,125V

No Fault and EN:
V_RFE: 3,6V

Tiefpass ca 16 kHz bzw 400 Hz
Fault Recovery: 350 us

C40 | C41 | VS(V) 3
22 µF | 0.1 µF | VB(V) 4

C42 | C43 | VB(W) 6
22 µF | 0.1 µF

Temperatur - Rth (NTC, VTH to VSS) -> Voltage at IC6 Mod:

heatsink to desired potential

min. ext. deadtime = 500 ns

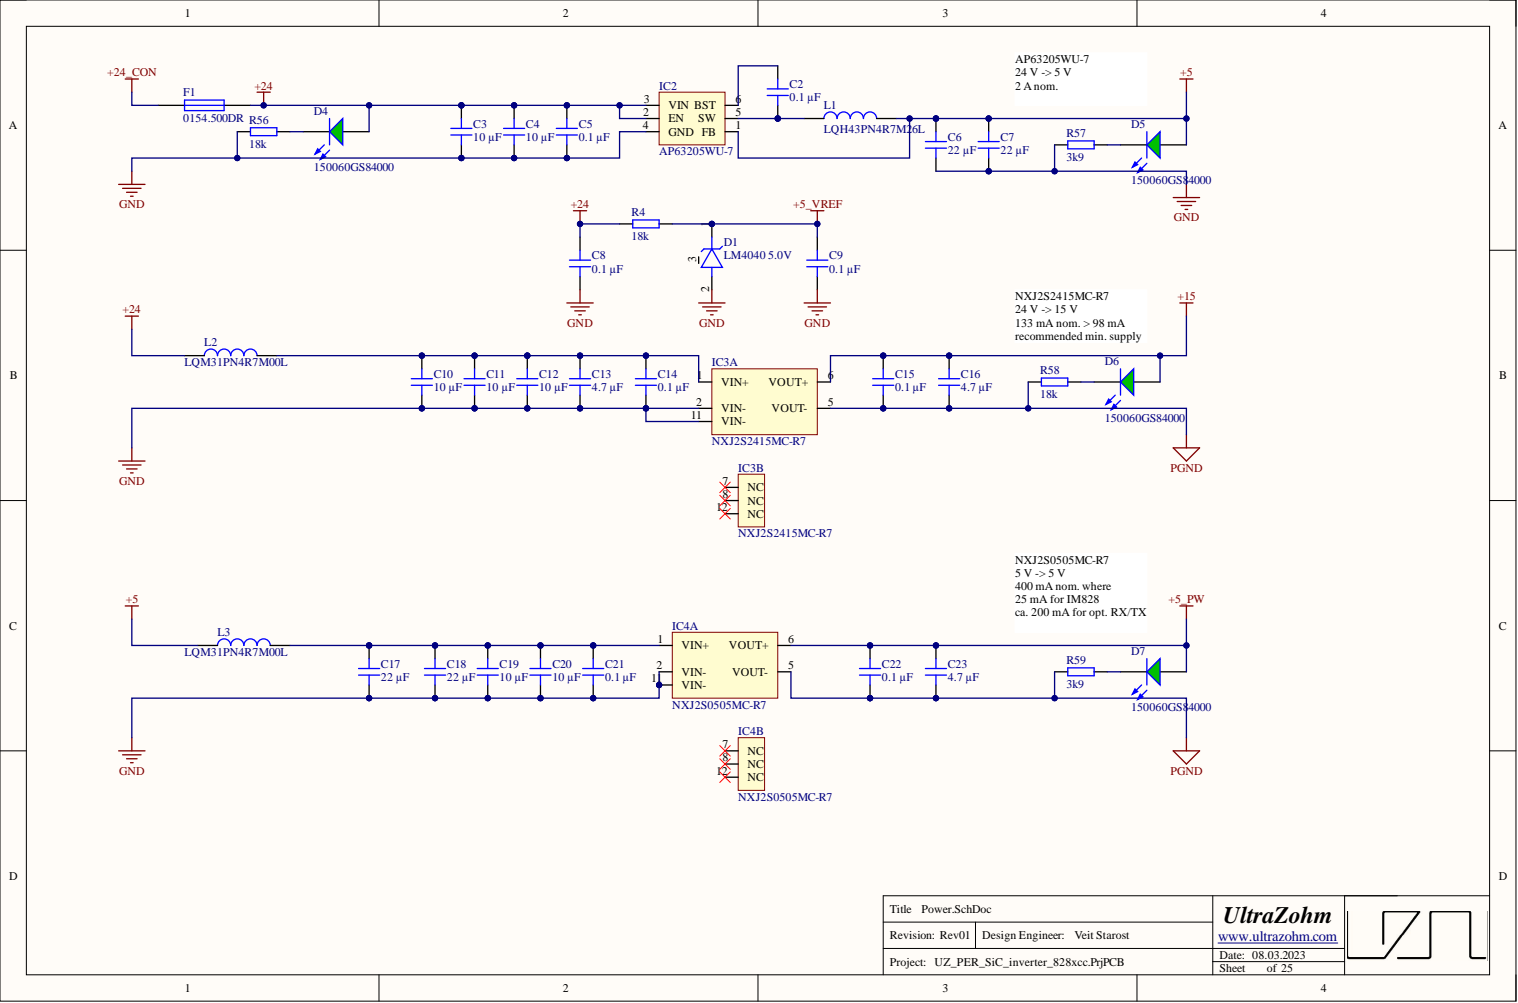
[picture p29: page 24]

10 µF | 4.7 µF | 0.1 µF | VIN- 2

NXJ2S0505MC-R7
400 mA nom. where
25 mA for IM828
ca. 200 mA for opt. RX/TX

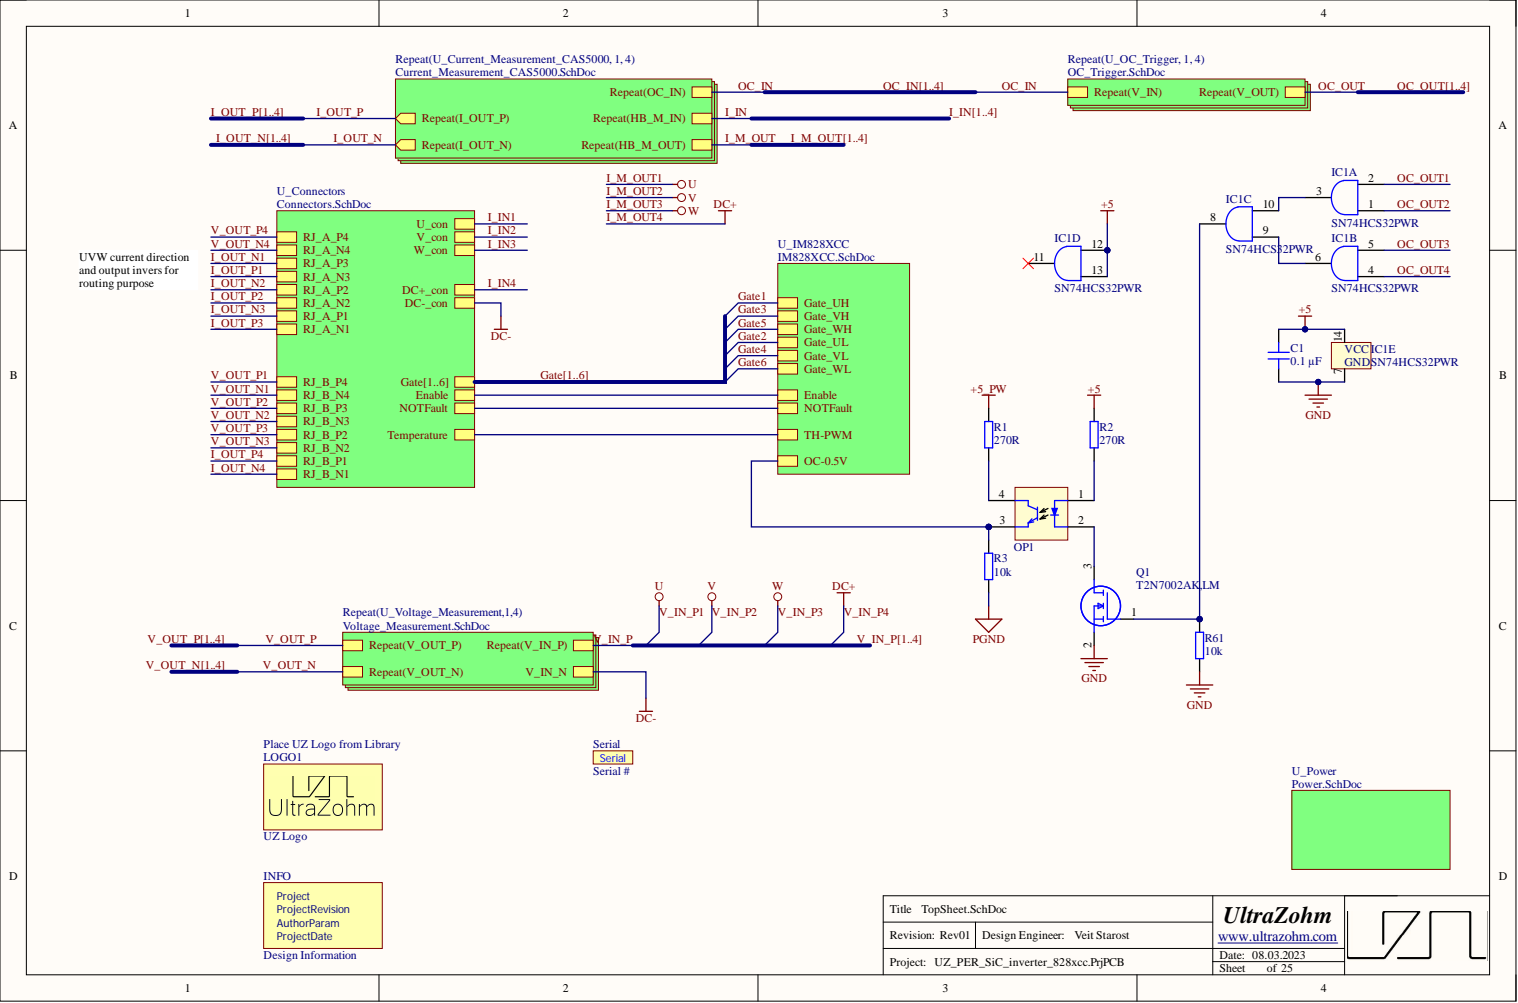
[picture p30: page 25]

Place UZ Logo from Library
LOGO1
