ultrazohm/uz_per_sic_inverter_828xcc/Project Outputs for UZ_PER_SiC_inverter_828xcc/Rev01/ASM_UZ_PER_SiC_inverter_828xcc_[No Variations]_Rev01.PDF

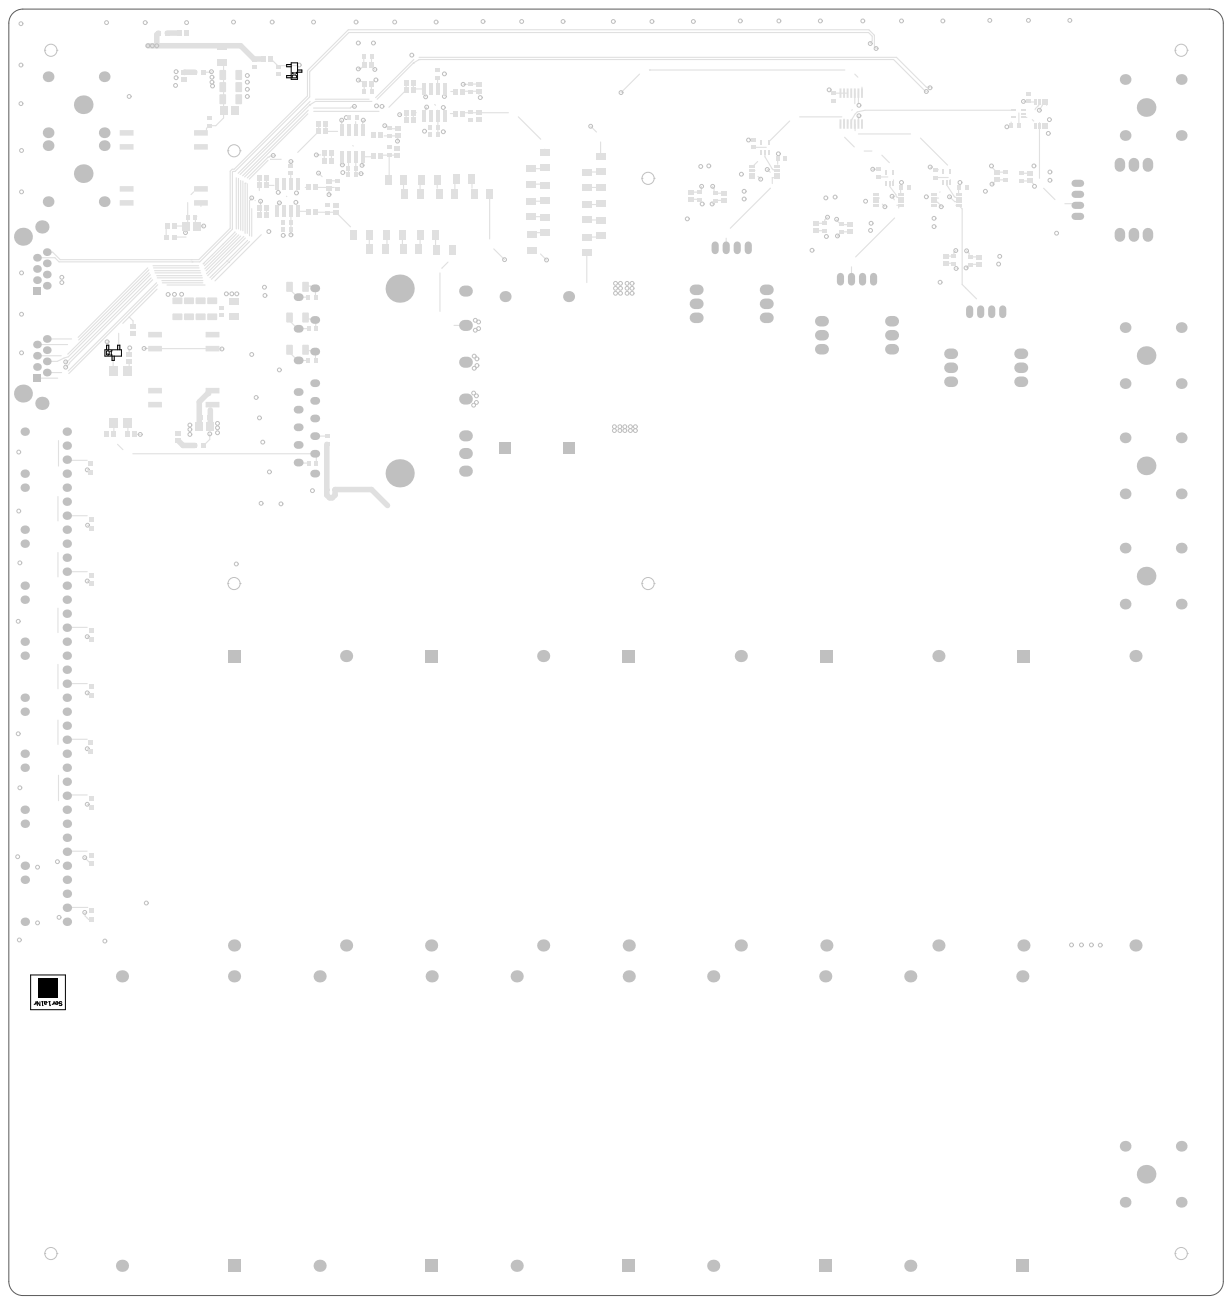
[picture p31: page 1]

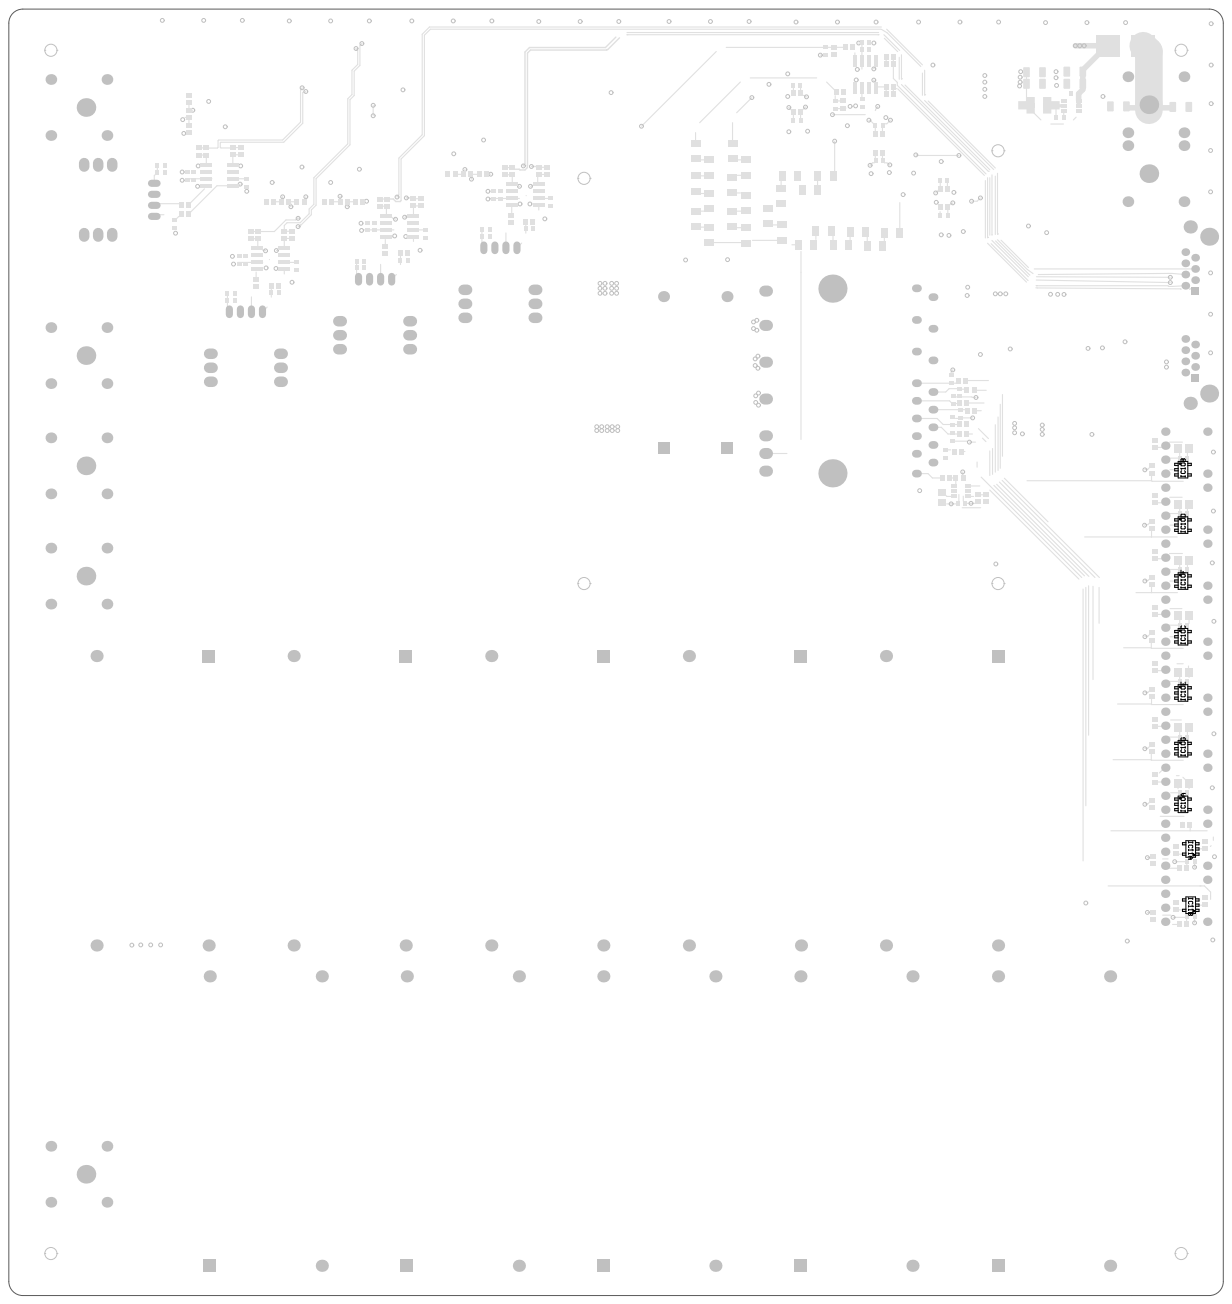
[picture p32: page 2]
