ultrazohm/uz_per_sic_inverter_828xcc/LTSpice/Draft1.asc

A1: schmtinv
D1: LED
D2: LED
R1: res; 3k9
R2: res; 10000
R3: res; 150
R4: res; 10000
R5: res; 287000
R6: res; 976000
R7: res; 182000
U1: LTC6992-4
V1: voltage; 5; Rser=0.1
V2: voltage; PULSE(0 5 0 0 0 0.01 0.02); Rser=0.1
V3: voltage; 0.14; Rser=0.1
Named nets: 0
.tran 0 0.02 0
