ultrazohm/uz_per_sic_inverter_828xcc/LTSpice/CurrMeas.asc

A1: xor
C1: cap; 1µ
C2: cap; 22p
C3: cap; 22p
C6: cap; 2n2
R3: res; 1k
R4: res; 2k
R5: res; 2k
R6: res; 1k
R7: res; 1k
R8: res; 33k
R9: res; 10k
R10: res; 10k
U1: ADA4940
U2: LTC6752
U3: LTC6752
V1: voltage; 5
V2: voltage; SINE(2.5 2.15 100)
V3: voltage; 2.5
V4: voltage; 0
Named nets: 0, 5v, o+, o-, i+
.tran 20m
;ac dec 100 1 100k
