ultrazohm/uz_per_sic_inverter_828xcc/LTSpice/VoltageMeas.asc

C1: cap; 1µ
C2: cap; 330p
C3: cap; 330p
C4: cap; 22p
C5: cap; 22p
R1: res; 1.98Meg
R2: res; 1.98Meg
R3: res; 500
R4: res; 220k
R5: res; 220k
R6: res; 220k
R7: res; 220k
R8: res; 22k
R9: res; 22k
R10: res; 500
U1: ADA4940
V1: voltage; 5
V2: voltage; SINE(282.5 200 100)
V3: voltage; 0
Named nets: 0, 5v, o+, o-, i+, i-
.tran 20m
;ac dec 100 1 1Meg
