ultrazohm/uz_per_sic_inverter_828xcc/(list of files, drawings)

Other design files:
Connectors.SchDoc
Current_Measurement_CAS5000.SchDoc
DCDCFix/5VFix/5VFix.PrjPcb
DCDCFix/5VFix/PCB1.PcbDoc
DCDCFix/15VFix/15VFix.PrjPcb
DCDCFix/15VFix/PCB1.PcbDoc
DCDCFix/15VFix/Sheet1.SchDoc
IM828XCC.SchDoc
OC_Trigger.SchDoc
Optical_RX.SchDoc
Optical_TX.SchDoc
Power.SchDoc
TopSheet.SchDoc
UZ_D_Template.PrjPCB
UZ_PER_SiC_inverter_828xcc.PcbDoc
UZ_PER_SiC_inverter_828xcc.PrjPCB
Voltage_Measurement.SchDoc
