ultrazohm/uz_per_sic_inverter_828xcc/(commit log)

2022-12-07 initial commit, added template files
    [DigitalCarrierJack.SchDoc, TopSheet.SchDoc, UZ_D_Template.PcbDoc, UZ_D_Template.PrjPCB]
2022-12-23 added some notes for the project
    [IM828_kritIC_Liste.xlsx]
2022-12-23 started schematics
    [Connectors.SchDoc, Current_Measurement_CAS5000.SchDoc, DigitalCarrierJack.SchDoc, IM828XCC.SchDoc, Optical_RX.SchDoc, Optical_TX.SchDoc, Power.SchDoc, TopSheet.SchDoc]
2023-01-02 schematic first draft finished
    [Connectors.SchDoc, Current_Measurement_CAS5000.SchDoc, IM828XCC.SchDoc, Optical_RX.SchDoc, Optical_TX.SchDoc, TopSheet.SchDoc, UZ_PER_SiC_inverter_828xcc.PrjPCB, Voltage_Measurement.SchDoc]
2023-01-10 pcb first draft finished
    [Connectors.SchDoc, Current_Measurement_CAS5000.SchDoc, IM828XCC.SchDoc, Optical_RX.SchDoc, Optical_TX.SchDoc, Power.SchDoc, TopSheet.SchDoc, UZ_PER_SiC_inverter_828xcc.PrjPCB]
2023-01-25 added OC function over ITRIP pin and solved issue1
    [Current_Measurement_CAS5000.SchDoc, OC_Trigger.SchDoc, TopSheet.SchDoc, UZ_PER_SiC_inverter_828xcc.PrjPCB]
2023-01-25 added logo and short describtion in oc_trig.sch
    [OC_Trigger.SchDoc, TopSheet.SchDoc]
2023-02-03 implemented changes suggested at first review
    [Connectors.SchDoc, Current_Measurement_CAS5000.SchDoc, IM828XCC.SchDoc, OC_Trigger.SchDoc, Optical_RX.SchDoc, Optical_TX.SchDoc, Power.SchDoc, TopSheet.SchDoc]
2023-02-13 some more changes requested by reviews
    [Connectors.SchDoc, Current_Measurement_CAS5000.SchDoc, IM828XCC.SchDoc, OC_Trigger.SchDoc, Optical_RX.SchDoc, Optical_TX.SchDoc, Power.SchDoc, TopSheet.SchDoc]
2023-02-14 - minor changes in the design: GND PGND connection, added layer for DC+ at im828, labels to LEDs - added comments in schematics - added some excel files that are useful for commissioning (adc convers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
    [Connectors.SchDoc, Current_Measurement_CAS5000.SchDoc, IM828XCC.SchDoc, IM828XCC_LTC6992HS6-4_dutycyc_to_temperature.xlsx, IM828_kritIC_Liste.xlsx, Power.SchDoc, TopSheet.SchDoc, UZ_PER_SiC_inverter_828xcc.PrjPCB]
2023-02-15 - add uz outputjob - add 1nf lcsc part number - add pcb outline on M1
    [IM828XCC.SchDoc, UZ_PER_SiC_inverter_828xcc.PrjPCB]
2023-02-15 final changes to BOM and layout, generated output files, ordered Rev01 at JLCPCB
    [BOM_JLC-UZ_PER_SiC_inverter_828xcc.xlsx, Connectors.SchDoc, Current_Measurement_CAS5000.SchDoc, IM828XCC.SchDoc, OC_Trigger.SchDoc, Optical_RX.SchDoc, Optical_TX.SchDoc, Pick Place for UZ_PER_SiC_inverter_828xcc.csv]
2023-02-21 changed design rules acc. to 2 oz restrictions of jlc. all 0.3 mm traces down to 0.2 mm and corrected placement and routing for having 0.2 mm spacing everywhere. Regenerated Output Files. THIS IS THE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
    [BOM_JLC-UZ_PER_SiC_inverter_828xcc.xlsx, Pick Place for UZ_PER_SiC_inverter_828xcc.csv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]
2023-03-13 DCDC footprint-fix-pcbs added
    [15VFix.PrjPcb, 5VFix.PrjPcb, PCB1.PcbDoc, Sheet1.SchDoc]
2023-06-13 renamed typo in dc fix pcb. added some docs incl. test procedure for dc fix pcbs
    [15VFix.PrjPcb, 5VFix.PrjPcb, IM828XCC_LTC6992HS6-4_dutycyc_to_temperature.xlsx, PCB1.PcbDoc, Sheet1.SchDoc, volts_to_adc.xlsx]
2023-06-27 added bootstrap measurements
    [0603 resistor-1.SLDPRT, 0603 resistor.SLDPRT, 0805 resistor-1.SLDPRT, 0805 resistor.SLDPRT, 1206 resistor-1.SLDPRT, 1206 resistor.SLDPRT, 5145.3021.0._BG1.02_CAS5050SRA-KH.SLDPRT, 6126536864-1.SLDPRT]
